jvanderberg/minipc-power/docs/skill-gaps.md

# kicad-skills gaps found while designing minipc-power

Running log of problems found in https://github.com/jvanderberg/kicad-skills (commit 3ba7b5f) while using it on this
board: things the skills miss, get wrong, or state without support. Each entry names the skill/file, what happened,
and a suggested fix.

Severity: **high** = would lead to a wrong or unsafe design if followed; **medium** = missing guidance that cost real
time or needed outside knowledge; **low** = friction, wording, tooling.

## General rules behind these gaps

The numbered entries below are incidents. Each one is an instance of one of these rules, and the rules are what the
skills should encode. Fixing only the exact incident would not prevent the next, different instance.

| # | Rule | Instances |
|---|---|---|
| R1 | **Requirements cover the whole operating envelope**: simultaneous loads, worst case, thermal, physical and connector area, what runs before what. | 1, 2, 3, 23, 25 |
| R2 | **Surface every assumption made in place of asking**, and never default it silently. The user decides. | 23, 26, 29 |
| R3 | **External data is a snapshot about one exact item**: stock, lifecycle, tool recommendations, datasheet values. Verify it is the exact orderable variant, and that the data is current, before building on it. | 10, 14, 29 |
| R4 | **Statements about third-party tools and sites go stale.** Date them, say how to re-verify them, and prefer steps that discover current behaviour. | 4, 11, 12, 32 |
| R5 | **Gather the authoritative references early, and re-consult them at the point of use.** Each phase starts from a brief that restates its own inputs and constraints, so it doesn't rely on what earlier parts of a long session remember. | 9, 13, 21, 22 |
| R6 | **Verify against the reference, not only against generic checks.** DRC/ERC prove electrical and manufacturing rules, not design intent. | 21, 24, 31, tool notes |
| R7 | **Every automated check has blind spots**: state what each one does not cover, and add a targeted check or a visual inspection for those. | 17, 31, 33, tool notes (silk under bodies, missing 3D models) |
| R8 | **Never suppress a whole category of validation output.** An exemption names the specific item and the reason, and is reported as exempted. | tool notes (DRC summary) |
| R9 | **A claim that a requirement can't be met is itself a claim needing evidence**: what was tried, what blocked it. Try the cheaper alternatives (smaller package, other value, other position) first. | 28 |
| R10 | **Decisions frozen in an earlier phase are checked for feasibility by the later phase before they are final.** If the later phase can't honour one, it goes back to the user as a decision, not a silent shortcut. | 26, 5 |
| R11 | **Shared resources need an allocation plan before sub-tasks consume them**: layers, board areas, routing channels, plane regions, reserved via sites. | 27 |
| R12 | **Every default or unused element is a recorded decision** (no-connect pins, straps, floating inputs), **and every external interface gets user-facing affordances** (labels, polarity, orientation). | 24, 33 |
| R13 | **One place owns each file format and each fiddly rule**: s-expression output, escaping, hole spacing. Generators describe intent, and shared tools enforce the rules. | 0, 16, 19, 20 |
| R14 | **Prefer standard, verified building blocks over imported or improvised ones**, and check imported ones against their source. | 17, 18, still-missing 8 |
| R15 | **Generated files are deterministic and match the tool's own canonical form.** An unchanged design regenerates byte-identical (stable ids from stable keys, stable order), a change touches only its own lines, and output matches what the tool itself writes (KiCad 10 stores net-class assignments as lists; we wrote strings, so every KiCad open rewrote them). Otherwise every rebuild is an unreviewable diff. | found moving minipc-power onto kicad_sexpr: random uuids + KiCad's uuid-sorted save gave a ~31,000-line diff for an unchanged board |

## Planning / interview (kicad-new-board)

1. **medium - No path for multi-amp 1S boards (power banks, handhelds).** `pcb-battery-power/SKILL.md` s4 makes a
   *linear* charger with power path the default for USB-powered 1S boards, and the scope note jumps from "1S hobby"
   straight to "tens of amps / e-bike packs - use a certified BMS". A 1S2P 18650 pack feeding a 5 V + 12 V boost at
   ~10-15 W (3-5 A from the cell) sits in between and is a very common hobby build (handheld emulators, portable
   displays, power banks). Nothing covers: switching NVDC chargers (BQ25895-class), power-bank SoCs (IP53xx, SW62xx),
   protector overcurrent thresholds vs a multi-amp boost load, or cell-current/derating for parallel cells.
   *Fix:* a "high-power 1S" section: switching charger with NVDC power path, protector + FET sized for boost peak
   current, parallel-cell matching, boost-from-cell current math (Iin = Pout / (eff x Vcell_min)).

2. **medium - The 15 W ceiling of 5 V USB-C is never applied to "charge while running".** `charging.md:102` says
   PD is needed above 15 W, but neither the interview guide nor the battery skill tells the planner to add the
   system load to the charge power and compare with what the input can deliver. Interview default "5 V, up to 1.5 A"
   (7.5 W) is below this board's load alone, so the default would have produced a board that discharges while
   plugged in. *Fix:* in interview step 4, require input power >= (system peak / eff) + (charge current x 4.2 V / eff)
   and recommend a PD sink when it fails.

3. **low - Interview has no "heat / enclosure thermal budget" question.** Size is asked, but "small sealed enclosure,
   must stay cool" was volunteered by the user and changes topology (switching vs linear charger, synchronous boosts,
   charge current limit). *Fix:* add "how hot may the board/box get, is there airflow?" to section 2 with a default.

## Battery / charging (pcb-battery-power)

5. **medium - PD sink coverage is one line, and misses the charger/PD interaction.** `charging.md:102` says "use a
   PD sink controller" and stops. Missing: (a) a charger's VINDPM (BQ25606: fixed 4.3 V / VBAT+200 mV) does nothing to
   protect a 9 V PD source, so the charger's input current limit must be at or below the negotiated PDO current
   (an 18 W charger gives 9 V / 2 A); (b) what the sink does when the requested voltage is not offered (CH224Q's
   datasheet does not say) and what input limit is safe then; (c) BC1.2-detecting chargers (BQ25606, BQ25895) only
   use the ILIM resistor when D+/D- detection returns "unknown" [BQ25606 s9.3.2.3], so whether D+/D- are wired to
   the connector changes the input limit. *Fix:* a "PD sink + charger" subsection covering these three.

6. **medium - Nothing on parallel cells (1SnP).** `chemistries.md` covers buying genuine 18650s but not paralleling
   them: same model/age, matched capacity, joined at the same voltage (or through a resistor) to avoid a large
   equalising current, one protector for the parallel group, per-cell current = pack current / n. *Fix:* a short
   section in `chemistries.md` or `protection-and-safety.md`.

7. **low - Protector trip current ignores gate drive.** `protection-and-safety.md:17` gives
   I_trip = V_OCD / (Rds,CHG + Rds,DSG), which is right, but the FETs in a DW01/HY2120 circuit are driven at roughly
   the cell voltage, so Rds(on) must be read at Vgs ~ 3 V (empty cell), not the 4.5 V headline figure - the trip
   current falls as the cell empties and the 8205A-class FETs trip around 3-5 A. *Fix:* add "read Rds(on) at
   Vgs = cell minimum" and a sizing example for a multi-amp load.

8. **low - Standalone vs I2C-default chargers not compared.** The battery skill names BQ2407x (linear), BQ25185 and
   BQ25895 (I2C) but not the standalone switching family (BQ25606/BQ25616: resistor-set ICHG/ILIM, no host). The
   power-supply skill's "startup independence" rule is the deciding argument and the battery skill should cross-link
   it: a charger that needs I2C cannot be configured by an MCU that it powers. *Fix:* add the standalone switching
   option to the charger-selection table in `charging.md`.

## Power design (pcb-power-supply)

9. **medium - WEBENCH is offered too late and too quietly.** The WEBENCH step is in `pcb-power-supply/SKILL.md` s3
   ("Choose the controller IC"), mid-paragraph. In practice the controller was chosen during kicad-new-board step 8
   (candidates) with pcb-part-selection, and the agent went straight to hand calculations from the datasheet; the user
   had to ask "do we have any tools for TI?" before WEBENCH was used. Neither kicad-new-board's component-selection
   step nor pcb-part-selection mentions it. *Fix:* in kicad-new-board step 8 and pcb-part-selection "Finding
   candidates", say: for any switching regulator, run WEBENCH (ask the user about the terms and a myTI login up front)
   *before* settling on a part and before hand sizing; make it a checklist item at the top of pcb-power-supply rather
   than a bullet inside s3. Also say plainly that WEBENCH does not cover battery chargers (BQ25xxx), so those stay
   datasheet-only.

10. **medium - WEBENCH results are not stock-filtered before use.** `webench.md` mentions "WEBENCH does not know what
    is in stock at JLC/LCSC" only in its last section, after the steps that pick and customize a design. On this
    board the 5 V run's top three (TPS61022, TPS61230A, TPS61236P) had 0 / 0 / 13 units in LCSC's global warehouse.
    Customizing any of them would have been wasted work. *Fix:* make the stock check step 2 of the WEBENCH flow: read
    the table view, pull every part number, run them through `jlcimport-cli search --region global` in one batch,
    and drop anything below the order quantity before opening Customize. A small script that takes the table text and
    prints stock per part would make this one command.

11. **low - WEBENCH can refuse a part the datasheet allows, without saying why.** Forcing TPS61178 at 3.0-4.35 V in,
    5 V / 2.5 A out returned "Design cannot be created! Your preferred device does not work with the inputs you
    selected" with no reason, although the datasheet allows 4.5-20 V out from 2.7 V in. `webench.md` does not say what
    to do then (vary Iout / Vin to find the limit, or fall back to the datasheet procedure). *Fix:* add a line on that.

12. **high (wrong statement) - "there is no KiCad/CAD export there" is false, and the PCB layout tab is not
    mentioned.** `webench.md` ("Export" paragraph) says the Export page has "no KiCad/CAD export". On 2026-10-24 the
    Export page offers **Altium Designer, Cadence OrCAD, TINA-TI, CadSoft EAGLE, Mentor Graphics and P-CAD** exports
    ("schematic, board, and simulation files"), and KiCad 10's `kicad-cli pcb import --format eagle|altium|pcad`
    reads three of those. Customize and Export also show a **PCB LAYOUT** tab with a per-layer reference layout
    (Top / Mid 1 / Mid 2 / Bottom). Following the skill, the agent skipped both and would have hand-placed every
    converter's hot loop instead of starting from TI's layout. *Fix:* replace the sentence; add a step: capture the
    PCB LAYOUT views for each chosen design and, with the user's permission to download, export EAGLE (or Altium),
    import with `kicad-cli pcb import`, and use the copper as the placement/routing reference for that converter
    (re-check against the datasheet layout guidelines; WEBENCH layouts use its own BOM footprints).

13. **medium - No "layout reference pack" step, and no stated order of authority between layout sources.**
    `pcb-power-supply` s6 says "copy the datasheet's layout example; then check against references/layout.md", and
    nothing else. Before placing any converter the skill should have the agent gather, per IC, into the project
    (e.g. `docs/layout-refs/<part>/`): (1) the datasheet's Layout Guidelines text and Layout Example figure (rendered
    with pdftoppm) - **primary, these win any conflict**; (2) the EVM user guide's layout if one exists; (3) the
    WEBENCH PCB LAYOUT views and imported EAGLE/Altium board - **reference only**, because they are drawn around
    WEBENCH's BOM (different inductor/capacitor sizes from the stocked LCSC substitutes) and a generic stackup.
    Then write down, per converter, the hot loop, the parts that must sit at the pins, the quiet-side parts, the
    feedback routing and the thermal-pad via count, and check the KiCad placement against that list. *Fix:* add
    this as a numbered step before s6 "Lay it out", and have kicad-pcb-workflow s1 ("Plan the change against real
    data") point to it for any switching converter.

## Schematic capture (kicad-pcb-workflow)

19. **medium (research miss) - No ready-made board setup / stackup; the agent had to hunt for syntax.** kicad-new-board
    says "set the physical stackup to the chosen JLC stackup" and `jlcpcb-stackups.md` gives the numbers, but nothing
    gives the KiCad syntax or a way to apply it: `kicad-cli` cannot create a project or board, and pcbnew's Python
    bindings do not expose `BOARD_STACKUP` (GetStackupDescriptor() returns an opaque SwigPyObject with no methods in
    KiCad 10.0.1). The agent ended up grepping the user's other projects for a board that happened to contain a
    `(stackup ...)` block to copy. *Fix:* ship template files with the skill - a blank 2-layer and 4-layer
    `.kicad_pcb` (+ `.kicad_pro` with JLC-safe design rules and net classes) per JLC stackup (JLC04161H-7628, -3313,
    ...), or a small script that writes the `(setup (stackup ...))` block and the `.kicad_pro` design settings from
    the table in `jlcpcb-stackups.md`.

16. **high - Nothing on creating a schematic or board from scratch, or on schematic readability.** kicad-pcb-workflow
    is entirely about *editing* existing files (checkpoint, patch, verify). It never covers: creating the project and
    first schematic, laying symbols out, and - since `kicad-cli` has no "update PCB from schematic" - getting a new
    schematic's footprints and nets onto a new board (has to be pcbnew python: load each footprint, set pad nets from
    the exported netlist). It also has no guidance on what a good generated schematic looks like; the default an agent
    reaches for is "every pin gets a net label", which the owner called unreadable. *Fix:* a "new design" section or
    a separate skill: (a) draw each functional block with real wires, power symbols for rails and ground, labels only
    between blocks; (b) left-to-right signal/power flow, inputs on the left, outputs on the right, ground at the
    bottom, supplies at the top; (c) minimise wire crossings, use junction dots only at real T-joins; (d) feel free to
    redraw an imported symbol with pins grouped by function (and fix "unspecified" pin types while doing it); (e)
    render the PDF and look at it before calling it done; (f) the netlist-to-board step with pcbnew.

17. **low - Imported footprints have no courtyard.** All 17 JLCImport footprints on this board lack F.CrtYd; the
    part-selection skill says to check for this, but kicad-pcb-workflow's DRC loop will not flag overlaps between
    parts without courtyards. *Fix:* add a script step that generates a courtyard (pad/body bounding box + 0.25 mm)
    for imported footprints that lack one.

18. **medium - Say up front that standard KiCad footprints are preferred over imported ones.** pcb-part-selection's
    "Importing into KiCad" treats the JLCImport footprint as the one to use (and then lists its usual defects). The
    owner's rule: **use KiCad's library footprint whenever the package is a standard one** (SOT-23, SOD-123F, 0402/0603,
    TI RGE/RHL/DQK, NexFET VSON-8, HRO USB-C, Littelfuse Nano2...), and keep the imported footprint only for genuinely
    part-specific packages (here: TPS61178 HotRod RNW, TPS63802 DLA, CH224Q DFN-10 with EP, FXL inductors). Notes for
    the skill: `jlcimport-cli import` has no switch for this (the GUI/TUI offer reuse; the CLI never passes the
    confirm callback), and its matcher `find_best_matching_footprint()` is wrong often enough that every suggestion
    needs checking - on this board it proposed a 12-pin 2x2.5 mm package for the 13-pin 3x3.5 mm TPS61178, a 3x2.5 mm
    package for the 3.5x4.5 mm TPS61088-Q1, a 3x3 mm EP part for the 2x3 mm TPS63802, Phoenix terminal blocks for both
    inductors and a 7.98x5.44 mm Bourns PTC for the Nano2 fuse. Also check pad numbering: KiCad's NexFET VSON-8
    merges source pins 5-8 into one pad "5", so the symbol needs matching pin numbers.

## Part selection (pcb-part-selection)

14. **high - No lifecycle (NRND/EOL) check, and distributor stock hides discontinued parts.** kicad-new-board step 8
    says "avoid NRND/EOL parts" but neither it nor pcb-part-selection says how to check. On this board WEBENCH
    recommended the TPS61088 (5 V boost) and LCSC listed 7,130 in stock, but ti.com/product/TPS61088 and its
    datasheet symlink both return 404 and TI's site search does not find it; only the automotive TPS61088-Q1 is
    still listed (ACTIVE). Stock at a distributor is not evidence that a part is still made. WEBENCH's own tell was
    "IC Cost: N/A" for that part (every active part showed a price). *Fix:* add to pcb-part-selection "Reading the
    datasheet": open the manufacturer's product page and record the lifecycle status (ACTIVE / NRND / LAST TIME BUY
    / OBSOLETE); a 404 product page or a missing datasheet link means treat as obsolete; and in webench.md, treat
    "IC Cost: N/A" as a lifecycle warning.

## Tooling

15. **low - render.py cannot render a board without an Edge.Cuts outline, even with --window.** It exits with "no
    Edge.Cuts outline found", which blocks rendering imported reference boards (the WEBENCH EAGLE imports have no
    outline). *Fix:* when --window is given, use it and skip the outline lookup.

4. **low - `jlcimport-cli` install not documented.** README lists it as a requirement with only a repo link. The
   repo's pyproject needs a modern pip (system Python 3.9 / pip 21 cannot do `pip install -e` on it) and a stale
   PyInstaller build in `dist/` lacks `--region`, which the skill's commands use. *Fix:* give the install command
   (`pipx install git+https://github.com/jvanderberg/kicad_jlcimport` or a venv with Python >= 3.11) and the minimum
   version that has `--region`.

## Routing (kicad-pcb-workflow)

20. **medium - no routing-as-data helper; the hand-written one missed same-net hole-to-hole spacing.** routing.md
    says to route with chosen coordinates kept as data, but ships nothing to do it, so each board writes its own
    track/via placer (`tools/routing.py` here). Its clearance check skipped same-net copper (right for copper
    clearance), so the GND pad-stitching pass put vias on top of hand-placed GND vias: 2 x `hole_to_hole` at 0.000 mm.
    DRC caught it. *Fix:* ship a tested router helper in kicad-pcb-workflow/scripts (pad lookup by REF/PIN, net taken
    from the pad, clearance + hole-to-hole + edge checks regardless of net, KiCad 10 s-expr output), or at least state
    the hole-to-hole rule in routing.md. Filed as https://github.com/jvanderberg/kicad-skills/issues/1.

21. **high - routing has no "follow the datasheet layout, then check against it" step.** kicad-pcb-workflow mentions
    the datasheet "layout example" only when choosing a part (SKILL.md:42). routing.md never mentions datasheet
    layout guidelines, the EVM or WEBENCH layouts, or a per-block compliance check. Here placement followed the
    figures. Routing drifted to pad coordinates and generic habits (global GND pour, a stitching via beside every GND
    pad), and those silently broke the BQ25606's own rules:
    - analog ground (ILIM/ICHG/TS resistors) must join power ground **only at the thermal pad**, but got plane vias
      and pour;
    - C_SYS belongs against SYS/GND pins 17/18 with a top-layer ground tie, but ended up 4 mm away, returning through
      the plane.
    DRC was clean throughout, so nothing flagged it. The user had to ask. *Fix:* in routing.md, make each converter /
    charger block a loop: (1) re-open that part's layout section and figure (plus the WEBENCH/EVM board as a secondary
    reference) before routing it; (2) route; (3) render the block net-coloured at the same scale as the figure and
    tick off each datasheet rule explicitly in a checklist file before moving on. Also call out the usual traps:
    single-point AGND vs blanket stitching/pour (a pour keepout is needed), cap ground returns on top copper vs via
    the plane, "no parallel layers on SW", and FB/COMP away from SW.

22. **high (process) - run each layout stage as its own agent session with a written brief (user suggestion).**
    Board design here is one very long session: requirements, part selection, WEBENCH, schematic, placement, routing.
    The datasheet layout figures and WEBENCH boards were collected early (docs/layout-refs/). By routing time they had
    dropped out of working attention, and were only re-read when the user asked (gap 21). A checklist file alone does
    not fix that if nothing forces it to be re-read. *Suggestion:* the skills should split layout into stages
    (placement; then routing per block: input/PD, charger, each converter, protection, planes/stitching; then review)
    and start each one in a fresh agent session. Each gets a brief built from the repo:
    - that block's datasheet layout rules and figure, plus the WEBENCH/EVM reference, from docs/layout-refs/<part>/;
    - its parts and nets (from netspec);
    - the board-wide rules (stackup, netclasses, keepouts);
    - the interfaces to neighbouring blocks (which pours and vias it must land on);
    - the done criteria: DRC clean, block nets connected, a net-coloured render compared with the datasheet figure,
      and every rule ticked in docs/layout-compliance.md.
    The brief is also the hand-off record, so a stage can be re-run without the whole conversation. Related: gap 21,
    and the s-expression/router tooling (gap 20), which makes stages independent because the board is regenerated
    from data rather than edited in place.

## Found in the end-of-session transcript review

Items from a pass over the whole session transcript (user corrections, tool failures, workarounds) that had not been
logged.

23. **medium - The interview never asks whether the board needs its own MCU / power controller.** The agent assumed
    "no MCU" without asking, and the user had to ask "when did we rule out an mcu?". The deciding argument (an
    external MCU cannot bootstrap its own power source, so anything that must be configured before the MCU runs
    needs a standalone part or an on-board controller) appears nowhere in kicad-new-board. *Fix:* add an interview
    question: "does anything need a controller before the main MCU runs (charger config, soft power switch, fuel
    gauge)?". Record the answer and the bootstrap argument in the requirements.

24. **medium - No guidance for pad-only (solder-point) boards: labels and polarity.** The user asked for every
    external connection as a solder pad. The skills say nothing about making such a board usable, and the user had
    to ask for "user readable labels and polarity" after the first 3D render. *Fix:* a short section in
    kicad-new-board / kicad-pcb-workflow:
    - every pad gets a function label on F.SilkS (and B.SilkS, mirrored);
    - consistent polarity: square = positive / signal, round = GND / negative;
    - pairs in a consistent order (+ then GND);
    - labels placed clear of footprint silk and courtyards (see the tool notes on silk under bodies and summary
      filtering).

25. **medium - The board-size estimate ignores connector / pad area.** The target was about 45 x 30 mm. 16
    through-hole solder pads plus two M2 holes (keep-out radius about 2.45 mm) pushed it to 52 x 36 mm, and the user
    had to offer more room. *Fix:* in kicad-new-board's size step, budget area for edge pads (pitch x count per
    edge), mounting-hole keep-outs and connector overhang before promising a size, and say the size is provisional
    until a placement pass.

26. **medium - Fine-pitch fan-out is not checked before the schematic is frozen.** CH224Q's D+/D- (0.4 mm pitch
    inner pins) could not be routed beside CC1/CC2 without crossings, so they were dropped at routing time. That
    quietly removed a feature (QC fallback on non-PD chargers). *Fix:* at placement (kicad-pcb-workflow s1), check
    escape routing for every pin of each fine-pitch part (<= 0.5 mm) against its connector before calling the
    schematic final. If a pin cannot escape, that is a schematic decision for the user, not a routing shortcut.

27. **medium - No board-level channel plan before per-block routing.** Routing block by block put the TS (thermistor)
    track on B.Cu under U6, exactly where the 3.3 V converter's PGND via had to go, and forced the EN bus to snake
    around the BAT strip. *Fix:* before routing any block, write a one-page layer / channel plan:
    - which nets own which inner-layer planes and B.Cu pours (e.g. the BAT strip);
    - reserved spots under each IC for ground / thermal vias;
    - the lanes for slow board-wide signals (EN, status, sense lines).

28. **medium - A layout rule marked "infeasible" needs recorded evidence.** The 12 V boost's VIN-pin bypass rule was
    written up as "no room", after checking only whether a 22 uF 0805 fitted. A 1 uF 0402 fitted (C37, added later).
    *Fix:* in the compliance checklist (gap 21), a deviation row must record what was tried: package sizes, positions,
    the blocking parts. The agent must try the smallest sensible package and a different value before declaring a
    datasheet rule unachievable.

29. **low - Switching to a part variant means re-deriving every value from that variant's datasheet.** WEBENCH
    designed around the commercial TPS61088, which turned out discontinued. The available TPS61088-Q1 has a
    different ILIM equation (R = 550000 / I, 0.6 V reference vs 1.204 V) and higher Rds(on). Neither webench.md nor
    pcb-power-supply warns that a variant (-Q1, A/B suffix, package option) can differ in equations and limits.
    *Fix:* a note: re-run WEBENCH on the exact orderable variant, or re-derive every resistor from that variant's own
    datasheet.

30. **low - Viewing vs editing, and reporting paths.** Two related frictions:
    - The kicad_open.sh lock makes the agent refuse to regenerate while the user only wants to look ("open it in
      kicad for me", "I won't edit it").
    - The user had to ask for full paths in summaries.

    *Fix:* for viewing, open a copy in the scratchpad (or say the board is read-only and will be regenerated on
    close). In kicad-new-board's reporting guidance, give absolute paths for every artifact.

31. **low - render.py full-board renders are unreadable once a GND pour exists.** Everything is one colour.
    kicad-board-review's view.py (net-coloured, with a grid) was the tool that worked for checking routing.
    *Fix:* kicad-pcb-workflow's rendering reference should point to view.py for routing checks, or render.py should
    gain a net-colour mode.

32. **low - Datasheet and reference-pack handling.** Several problems:
    - TI datasheet "symlink" URLs return an HTML page (not a PDF) for discontinued parts.
    - pdftotext prints font errors on some TI PDFs.
    - The layout pack saved neighbouring pages without saying which PNG holds the figure, and the support page was
      opened twice in place of the layout example.

    *Fix:* the download step checks the `%PDF` magic. The pack README names the figure page per part (e.g.
    `tps61178-12v/datasheet-p30.png = fig. 36`). A small "find the page that contains section X / figure N" helper
    would replace the repeated grep-per-page loops.

33. **low - No-connect pins hide decisions.** ERC no-connect flags make every unused pin pass silently. TPS61088-Q1's
    MODE pin was left floating (correct: internal 800 k pull-up selects PFM), but that was only checked at routing
    time. *Fix:* a no-connect audit that lists each NC pin with the datasheet pin-table text, so each choice is made
    deliberately.

## Found running kicad-board-review (2026-10-24, GitHub main 77055cd)

34. **medium - The starter review config silently classifies most switch nodes as "slow".** `make_pack.sh` writes
    `review_config.example.json`, whose switch regex (`-SW\d?\)$|_LX$|^SW_NODE`) only matches nets KiCad names after an
    IC's SW pin. Here two of three converter switch nodes were named after a capacitor pad (`Net-(C4-Pad2)`,
    `Net-(C24-Pad2)`) and the buck-boost's are `U6-L1/L2`; the first pack reported "loops 0 fast 0" with no warning.
    *Fix:* classify switch nodes from the netlist (a net joining an IC pin named SW/LX/L1/L2/PH to an inductor), and
    have `emc.py` warn when an inductor-connected net or a configured hot-loop IC ends up unclassified.

35. **medium - `nc_audit.py` treats a no_connect-typed pin as decided.** U5 (TPS61088-Q1) pins 11/12 were "symbol NC"
    with an empty note and passed `--require-notes`, but the pin table says "connect these two pins to ground plane".
    *Fix:* a pin named NC still needs a datasheet note; print the pin-table text for it like any other unused pin.

36. **medium - Design currents ignore the source's own series resistance.** The checklist and the battery skill size a
    battery path as P / (eff x Vcell_min). With ~70-100 mOhm of FETs, fuse, BATFET, copper and wires, 15 W at a 3.0 V
    cell is 6.8 A, not 5.6 A, past this charger's 6.0 A BATFET trip (latches off until USB). *Fix:* solve
    I x (Vcell - I x R_path) = P / eff and compare with every element's limit (BATFET OCP, protector, fuse derating,
    converter UVLO at the resulting VSYS); `power.py` could report the copper part of R_path per run.

37. **medium - "Small capacitor at the pins" items from the datasheet's typical application are easy to drop.** WEBENCH's
    BOM for the TPS61088 omitted the 1 uF output capacitor that the datasheet's typical application (C9) and layout
    figure show at the VOUT pins; the compliance check ticked "C_OUT at the VOUT pins" against the 47 uF parts 3 mm away.
    *Fix:* in pcb-power-supply's reference-pack step, list every capacitor in the datasheet's typical application with
    its position in the layout figure, and diff that list against the BOM (WEBENCH is a secondary source).

38. **low - Load-switch and inrush timing is not in any checklist.** A P-FET load switch driven straight from EN
    (Q5, 10 nF gate cap) connected the load before the boost started; inrush then comes through the boost's rectifier
    body diode with no limit. *Fix:* checklist item: every output switch has a defined turn-on time, compared with the
    upstream converter's soft-start and the upstream current trips.

39. **low - `board_diff.py` bugs.** (a) `board_diff.py HEAD <board>` fails when the board is not at the repo root: it runs
    `git show HEAD:<basename>` with cwd = the board's folder, which git resolves from the repo root (use `HEAD:./<name>`).
    Worked around with `HEAD:hardware/minipc-power.kicad_pcb`. (b) It does not report changed footprint fields: R7, R16
    and C32 value / LCSC changes were invisible ("0 unexpected change groups").

40. **low - `check.sh` cannot see a project's pin-decision notes.** It runs `nc_audit.py` without `--notes`, so it
    reports "19 without a decision" for a project whose own build finds 0 (notes in `docs/pin-decisions.json`). *Fix:*
    `--notes FILE` passthrough, or look for `pin-decisions.json` next to the project / in `docs/`.

41. **low - `planes.py` reports a pour of another net as one board-sized slot.** The B.Cu BAT pour plus the tracks that
    touch its clearance came out as a "44.4 x 31.9 mm slot" (the bounding box of the merged hole). *Fix:* report other-
    net pours separately from slots, and give each slot its own extent.

42. **low - `emc.py` reference check on a 4-layer board with a power plane.** Every B.Cu track is "not over ground"
    because the nearest plane is In2 (VSYS), even where it runs inside a B.Cu GND pour. That's correct as geometry but
    drowns the list; say "over VSYS plane (decoupled?)" as a separate, lower-priority category.

43. **low - The hot-loop metric measures pad-to-pad geometry only.** U6's loop looked fine (2-2.5 mm) while its
    return went through one 0.2 mm via; the solver showed it. *Fix:* for each configured hot loop, run a small DC solve
    from the cap's GND pad to the IC ground pin and report the via share and the top-layer share.

44. **low - Environment.** `jlcimport-cli` was not installed (the README's `pipx install git+...` worked: v1.6.7);
    KiCad's python prints a wx "traits" assert on every `boarddump.py` run; `view.py` puts the title and some labels
    outside the axes for small windows. `docs/layout-refs/tps63802-3v3/` holds p28 and p29 with nothing
    saying fig. 12-1 is on p28 (p29 is the documentation-support page; gap 32 again).

45. **medium - The project builds deterministically only against an unpublished kicad-skills.** With GitHub main's
    `kicad_sexpr`, `gen_schematic.py` writes random uuids (an unchanged design gave a ~18k-line diff). The deterministic
    writer is on an uncommitted local branch. Publish it, and pin the kicad-skills revision a project builds with
    (e.g. a `KICAD_SKILLS_REV` in `tools/kskills.py` checked at build time).

## Found during the datasheet, heat and protection rework (2026-10-25, kicad-skills main 8dcd3da)

46. **high - Datasheet links were dropped by every stage.** All 87 BOM parts had empty Datasheet fields in the schematic
    and on the board although JLCImport writes an LCSC link into every symbol it imports: the redrawn symbols started
    from `datasheet=''`, passives kept KiCad's "~", schgen ignored the library value and board_setup never copied the
    netlist's `<datasheet>` element. Fixed here (symbols.DATASHEETS, LCSC link per part, board_setup copies it, generators
    refuse a blank) and in kicad-skills (R22, `partfields.py`).

47. **high - Heat was never budgeted.** The review skill had no thermal model ("temperature rise needs judgment") and a
    one-line checklist item with no required output, so it was skipped. The battery path (protection FETs, BATFET, fuse)
    turned out to be 3-4 times the converter losses at the 15 W corner. See thermal.md; kicad-skills branch `thermal`
    adds the heat table and solver (R23).

48. **high - Stock was checked in the wrong region.** `jlcimport-cli search` without `--region` uses the CLI's default
    (here `cn`): the first FET chosen for the heat fix (SiSS80DN, C3289423) showed 12,000 in stock, the user approved it,
    and the block was re-laid out around it before `bom_check.py` (`--region global`) reported 0 for JLCPCB assembly.
    Availability belongs to (part, assembler, region, quantity, date) and has to be checked at selection time.

49. **medium - A part swap changed a derived value and an approved decision.** The HY2113 senses over-current across
    Q2 + Q3, so the trip current depends on the FET's RDS(on): the protector variant had to be re-chosen for each FET,
    and the substitution was started without asking. Derived values need a "depends on" note so a swap re-derives them,
    and a change to an approved part or threshold goes back to the owner.

50. **low - `power.py` crashes on a renamed net.** After the part swap KiCad renamed `Net-(J3-Pad1)` to `Net-(Q1-D)`;
    the run failed with a numpy NaN error instead of "run batn_q1: net not on the board".

51. **low - `bom_check.py`'s summary swaps two counts** ("0 extended, 38 without a datasheet link" meant the reverse).

52. **low - via_near put vias inside a neighbouring same-net pad** (Q3's source pads): via_ok's obstacle set skips
    same-net copper, so an unfilled via landed in the next pad. Fixed in tools/routing.py (no via on any pad but the
    one it stitches).

## Tool notes

Changes or workarounds to existing tools (skills' scripts, jlcimport). None of the skills' scripts have been modified
so far; workarounds are listed here.

- `render.py` (kicad-pcb-workflow): refuses boards without Edge.Cuts even with `--window` -> worked around by adding
  a temporary `gr_rect` outline to a copy of each imported WEBENCH board (`docs/layout-refs/*-view.kicad_pcb`).
- `jlcimport-cli import`: no way to choose a KiCad library footprint -> footprints are assigned in the schematic
  generator instead; the importer's matcher was called directly from Python to get its suggestions.
- KiCad 10.0.1's library footprints reference 3D models that are not installed (Fuse_Littelfuse-NANO2-451_453,
  USB_C_Receptacle_HRO_TYPE-C-31-M-12): the 3D render silently shows bare pads. Worked around by pointing those
  footprints at the JLCImport models (`placement.MODEL_OVERRIDE`, offsets corrected for the KiCad footprint origin).
  The skill's 3D-render step should check every footprint's model path exists and flag missing ones.
- pcbnew python: `FOOTPRINT.Models()` returns copies, so setting `m_Filename` / `m_Offset` on them does nothing
  (no error). Model paths are rewritten as text in `tools/board_setup.py`. Belongs in `pcbnew-api.md`'s failure table.
- `tools/routing.py` (this repo): `via_ok` now rejects any via within `(size_a + size_b)/2 + 0.1 mm` of an existing
  via of any net (gap 20).
- `tools/routing.py` (this repo): added `keepout()` (pour-free rule areas, KiCad 10 syntax copied from a library
  footprint's keepout zone) for the analog-ground islands of the charger, 12 V and 3.3 V converters (gaps 21-22).
- KiCad DRC passed with pad labels (F.SilkS) under component bodies. It only checks silk against pads, so the 3D
  render was the only thing that caught it. A "silk text vs courtyard" check belongs in check.sh or the board review.
- `tools/build_board.sh` (this repo): its DRC summary dropped every `silk*` type to hide one known warning (J1's
  outline at the board edge). That hid three real silk overlaps (pad labels printed over J16 / J7 outlines), which KiCad
  had reported. Now only that exact J1 case is exempted. Lesson for the skills' check.sh / drc_summary: exempt
  specific known items by name, never a whole category.
- `jlcimport-cli import C6331050`: "No component found" (no EasyEDA data) -> substituted FXL0530-R47-M (C475515).

## Tools that would have prevented the issues found so far

Built for this project (in `tools/`, candidates to move into the skills):

1. **`netspec.py` - intended netlist vs KiCad export.** The circuit written once as data ({net: [REF.PIN...]}),
   compared with `kicad-cli sch export netlist`: reports SPLIT (one intended net became several) and SHORT (a KiCad
   net mixes intended nets), tolerant of two-pin passive orientation. ERC did not catch VSYS shorted to GND in the
   first generated draft (it only complained about an open-collector pin on a power output); this did, immediately.
2. **`schgen.find_merges()` - locate the short.** Union-find over the drawn geometry (wire ends, pin points, power
   symbols, labels) that prints the exact wire or pin coordinates where two intended nets merge. Turned "VSYS is on
   GND somewhere" into "C14 pin 2 at (105.41, 242.57) sits on the FB wire".
3. **`schgen.Sch` - wire-drawn schematic writer** with pin-coordinate transforms (rotation/mirror), automatic
   junctions, wire splitting at T-taps, and no reliance on net labels inside a block.
4. **`symbols.ic()` / `symbols.fet()` - symbol redraw.** Pins grouped by function with real pin types and stacked
   duplicates; FET symbols renumbered to the KiCad footprint's pads (e.g. NexFET pad 5 = merged source).
5. **`symlib.py` / `fpinfo.py` - dump symbol pins and footprint pads** side by side to check numbering before
   assigning a footprint.

Still missing (would have helped):

0. **(highest value) An s-expression object model + serializer for KiCad files, in the skills layer.** This
   project's generator builds `.kicad_sch` text with hand-written format strings
   (`'\t\t(property %s %s\n\t\t\t(at %s %s %s)...' % (...)`). That caused two of this session's bugs (a stray
   `'''` fragment inside a format string, and a duplicated property name) and makes every new feature (mirrored
   symbols, extra visible fields, field angles) a string-surgery exercise. What the skill should provide: typed
   objects (Sheet, SymbolInstance, LibSymbol, Pin, Wire, Junction, Label, PowerSymbol, Text; Board, Footprint, Pad,
   Track, Via, Zone) with one serializer that writes KiCad 10 syntax, uuids, instances and lib_symbols embedding, plus
   a reader for round-trips - so a generator only describes the logical design ("place U2 here, wire VBUS to C2.1")
   and never formats text. The same layer can enforce the gotchas file-format.md lists (no raw newlines, escaped
   quotes, `{slash}` in board net names, insertion anchors). Existing open-source Python libraries to evaluate
   first rather than writing from scratch: kiutils, kicad-skip (not checked here for KiCad 10 format support).

6. **Collision check before writing**: any part's pin landing on another net's wire, two wires sharing a column/row
   segment, a part body overlapping a wire or another body, and text overlapping text - all checkable from the
   geometry the generator already has. Most of this board's drawing faults were "a shunt cap's ground pin lands on a
   signal wire that runs 7.62 mm below the rail it hangs from".
7. **Block layout helpers** that reserve space: "ladder" placement (rail on top, shunts below with their ground
   symbols, signals routed below the lowest ground symbol) so the generator cannot put a signal row inside a shunt's
   span.
8. **Footprint vs datasheet land-pattern check**: pad count, pitch, EP size and pin-1 position from the datasheet's
   recommended land pattern against the chosen footprint; and a matcher wrapper that refuses a KiCad footprint whose
   body size or pin count differs from the LCSC package string (jlcimport's matcher proposed wrong sizes/pin counts
   for four parts).
9. **Lifecycle + stock gate**: one command that takes every MPN/LCSC number and reports manufacturer lifecycle
   (product page status, 404 = suspect) and LCSC global stock vs order quantity - would have caught TPS61088
   (discontinued, distributor stock still listed) and the HY2120 2-cell mix-up if it also echoed the datasheet title.
10. **WEBENCH table -> stock filter**: paste/scrape the table view's part numbers and get stock per part before
    customizing anything.
