jvanderberg/minipc-power/docs/webench/12v-tps61178.md

# WEBENCH: 12 V rail, TPS61178RNWR (design 33, 2026-10-24, logged in)

Inputs: Vin 3.0-4.35 V, Vout 12 V, Iout 0.5 A, ambient 50 C, max height 5 mm, ceramic caps, shielded inductors,
Balanced. Customized: user frequency 1.0 MHz, current limit 4.5 A (WEBENCH default was 9.37 A), PFET isolation on.

| Ref | Value | WEBENCH MPN | Notes |
|---|---|---|---|
| L1 | 2.7 uH, 18 mOhm DCR | Murata 1255AY-2R7N=P3 (IDC 4.6 A) | need I_sat > ILIM max (~6.2 A) - substitute |
| Cin | 2 x 22 uF 16 V 1210 (36 uF derated) | Taiyo MSASE32MSB7226MPNB25 | |
| Cout | 3 x 22 uF 25 V 1210 (31 uF derated) | Murata GRM32ER61E226KE15L | |
| Cout1 | 4.7 uF 25 V 1206 (3.2 uF derated) | TDK C3216X7R1E475K160AC | before the disconnect FET |
| Cvcc | 4.7 uF 25 V 0805 | | |
| Cboot | 100 nF 0805 | | |
| Rt | 169 k | | 986.6 kHz |
| Rilim | 162 k | | 745/162 = 4.6 A typ |
| Rfbt / Rfbb | 732 k / 80.6 k | | 12.08 V |
| Rcomp / Ccomp | 44.2 k / 1.8 nF | | no Cp |
| Rgate / Cgate | 178 k / 22 nF | | disconnect FET gate |
| M3 | P-FET -20 V | TI CSD25404Q3 | |

Operating values at Vin 3.0 V, Iout 0.5 A: efficiency 94.8 %, phase margin 54.9 deg, crossover 13.0 kHz, gain margin
reported "-11.91 dB" (gain at the phase crossover), duty 75 %, L ripple 0.82 App, IC peak switch current 2.31 A,
average input 2.11 A, Cout RMS 0.91 A, Cin RMS 0.12 A, IC Pd 251 mW, L Pd 80 mW, total Pd 331 mW, IC Tj 57.1 C at
50 C ambient (theta-JA 28.5 C/W assumed), Vout ripple 15 mVpp, Vout tolerance 2.84 %.
