jvanderberg/minipc-power/docs/webench/3v3-tps63802.md

# WEBENCH: 3.3 V rail, TPS63802DLAR (design 36, 2026-10-24, logged in)

Inputs: Vin 3.0-4.35 V, Vout 3.3 V, Iout 1.5 A, ambient 50 C, max height 5 mm, ceramic caps, shielded inductors.

Candidates vs LCSC global stock: TPS63802DLAR 37,457 (chosen); TPS63805YFFR 5,445 (WCSP/BGA - avoid);
TPS63806 78; TPS63810 260 (I2C); TPS63811 0; TPS63020DSJR 23,487 (older, 25-50 uA Iq, 3x4 VSON; fallback).

| Ref | Value | WEBENCH MPN |
|---|---|---|
| L1 | 470 nH, 7.6 mOhm | Coilcraft XFL4015-471MEB (IDC 9.1 A) - substitute |
| Cin | 22 uF 6.3 V 0603 (8.7 uF derated) | Murata GRM188R60J226MEA0D |
| Cout | 22 uF 10 V 0805 (11 uF derated) | Taiyo MSASL219LB5226MTNA01 |
| Rfbt / Rfbb | 511 k / 91 k | 3.31 V |
| Rpg | 100 k | PG pull-up |

At 3.0 V / 1.5 A: eff 91.1 %, 1.36 MHz, CCM, L ripple 0.64 App (36.5 %), IC peak 2.06 A, Iin 1.81 A, IC Pd 457 mW,
L Pd 24 mW, total 483 mW, IC Tj 65.6 C (theta-JA 34 C/W), Vout ripple 19.8 mVpp, tolerance 2.73 %.
(No loop data: internally compensated.)
