jvanderberg/minipc-power/docs/layout-refs/webench-raw/d33/ExportFiles/Schematic/webench_schematic_exchange_design_18395157_33_Eagle/Eagle/2026-10-24_14-10-09/readme.txt

 

**********************************************************
*************  Important Instructions Follow  ************
**********************************************************
 
All files exported to: C:\\CADExport\\workspace\Eagle\2026-10-24_14-10-09\2026-10-24_14-10-09

To import your new library into Eagle:
1. Start Eagle.
2. In the control panel window, Select File -> New -> Library from the menu.
3. In the blank library window, select File -> Execute Script from the menu.
5. Browse to your newly exported Eagle Script file (".scr" file extension)
6. After opening the file, the script will populate the new library.
7. Use File -> Save (or Save As..) to save the library to the desired location in Eagle native format.

**************************************************************
**    !!!!!!!!!!!!!        WARNING        !!!!!!!!!!!!!     **
**************************************************************

Besure to check the documentation layer, "48"/"Document", for important information that may seem to be missing or have not translated properly!

For additional information, please visit this site:
http://www.accelerated-designs.com/help/Eagle_import.html

You may also find this video helpful:
http://youtu.be/5jGuWY-Yy3Q

Ultra Librarian Gold 8.3.103 Process Report

Message - Padstack "RX44Y57D0T" Shape(4) is a CIRCLE with no diameter.
Message - Padstack "RX44Y106D0T" Shape(4) is a CIRCLE with no diameter.
Message - Padstack "R10632240000200A" Shape(4) is a CIRCLE with no diameter.
Message - Padstack "RX14Y13D0T" Shape(4) is a CIRCLE with no diameter.
Message - Padstack "RX22Y24D0T" Shape(4) is a CIRCLE with no diameter.
Message - Padstack "R10280100000200A" Shape(4) is a CIRCLE with no diameter.
Message - Padstack "R10141380000206A" Shape(4) is a CIRCLE with no diameter.
Message - Padstack "RX44Y71D0T" Shape(4) is a CIRCLE with no diameter.
Message - Padstack "R10200250000209A" Shape(4) is a CIRCLE with no diameter.
Message - Symbol "CSD25404Q3DQG" has as multiple attributes named "Value".
One of the attributes was renamed to "VALUE_2".
Message - Symbol "WB_CAPACITOR" has as multiple attributes named "TYPE".
One of the attributes was renamed to "TYPE_2".

TextStyle count:  24
Padstack count:   9
Pattern count:    8
Symbol count:     8
Component count:  19

Export

Component "WB_BATTERY" has no mapped footprint will be skipped.
Component "WB_GND" has no mapped footprint will be skipped.
Component "WB_CURRENT_LOAD" has no mapped footprint will be skipped.
