jvanderberg/minipc-power/docs/layout-refs/webench-raw/d36/ExportFiles/Schematic/webench_schematic_exchange_design_18395157_36_Eagle/Eagle/2026-10-24_14-12-33/readme.txt

 

**********************************************************
*************  Important Instructions Follow  ************
**********************************************************
 
All files exported to: C:\\CADExport\\workspace\Eagle\2026-10-24_14-12-33\2026-10-24_14-12-33

To import your new library into Eagle:
1. Start Eagle.
2. In the control panel window, Select File -> New -> Library from the menu.
3. In the blank library window, select File -> Execute Script from the menu.
5. Browse to your newly exported Eagle Script file (".scr" file extension)
6. After opening the file, the script will populate the new library.
7. Use File -> Save (or Save As..) to save the library to the desired location in Eagle native format.

**************************************************************
**    !!!!!!!!!!!!!        WARNING        !!!!!!!!!!!!!     **
**************************************************************

Besure to check the documentation layer, "48"/"Document", for important information that may seem to be missing or have not translated properly!

For additional information, please visit this site:
http://www.accelerated-designs.com/help/Eagle_import.html

You may also find this video helpful:
http://youtu.be/5jGuWY-Yy3Q

Ultra Librarian Gold 8.3.103 Process Report

Message - Padstack "RX26Y38D0T" Shape(4) is a CIRCLE with no diameter.
Message - Padstack "RX22Y24D0T" Shape(4) is a CIRCLE with no diameter.
Message - Padstack "R10280140000202A" Shape(4) is a CIRCLE with no diameter.
Message - Padstack "R10390140000202A" Shape(4) is a CIRCLE with no diameter.
Message - Padstack "R10550140000227A" Shape(4) is a CIRCLE with no diameter.
Message - Padstack "RX44Y128D0T" Shape(4) is a CIRCLE with no diameter.
Message - Padstack "RX44Y128D0TSM2" Shape(4) is a CIRCLE with no diameter.
Message - Padstack "RX44Y57D0T" Shape(4) is a CIRCLE with no diameter.

TextStyle count:  24
Padstack count:   8
Pattern count:    5
Symbol count:     7
Component count:  10

Export

Component "WB_GND" has no mapped footprint will be skipped.
Component "XFL4015-471MEB" has the following missing dependency and will be skipped: Footprint "XFL4015-M"
Component "WB_CURRENT_LOAD" has no mapped footprint will be skipped.
Component "WB_BATTERY" has no mapped footprint will be skipped.
