jvanderberg/minipc-power/docs/layout-refs/bq25606-charger/datasheet-p34-34.png

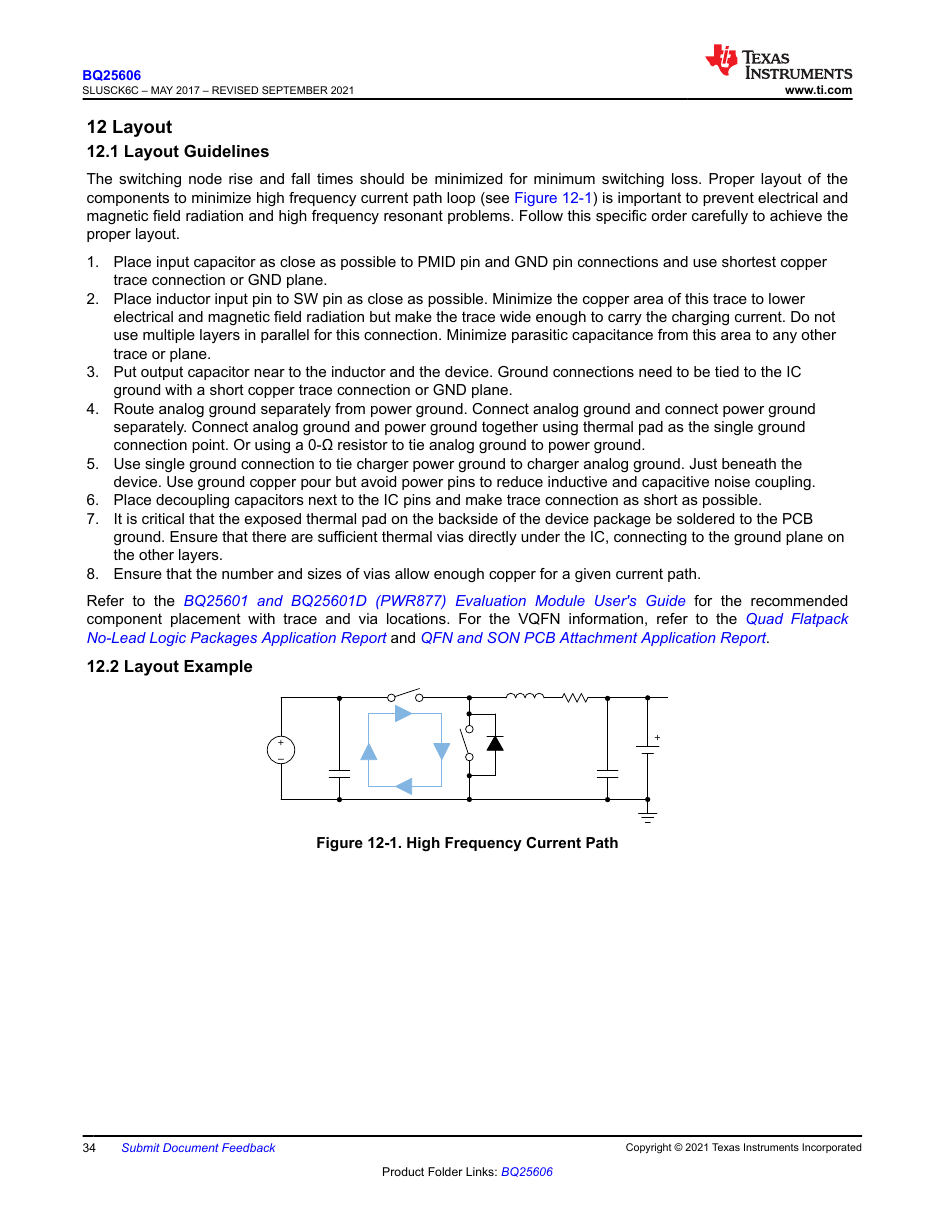
docs/layout-refs/bq25606-charger/datasheet-p34-34.png
