jvanderberg/minipc-power/docs/layout-refs/bq25606-charger/datasheet-p35-35.png

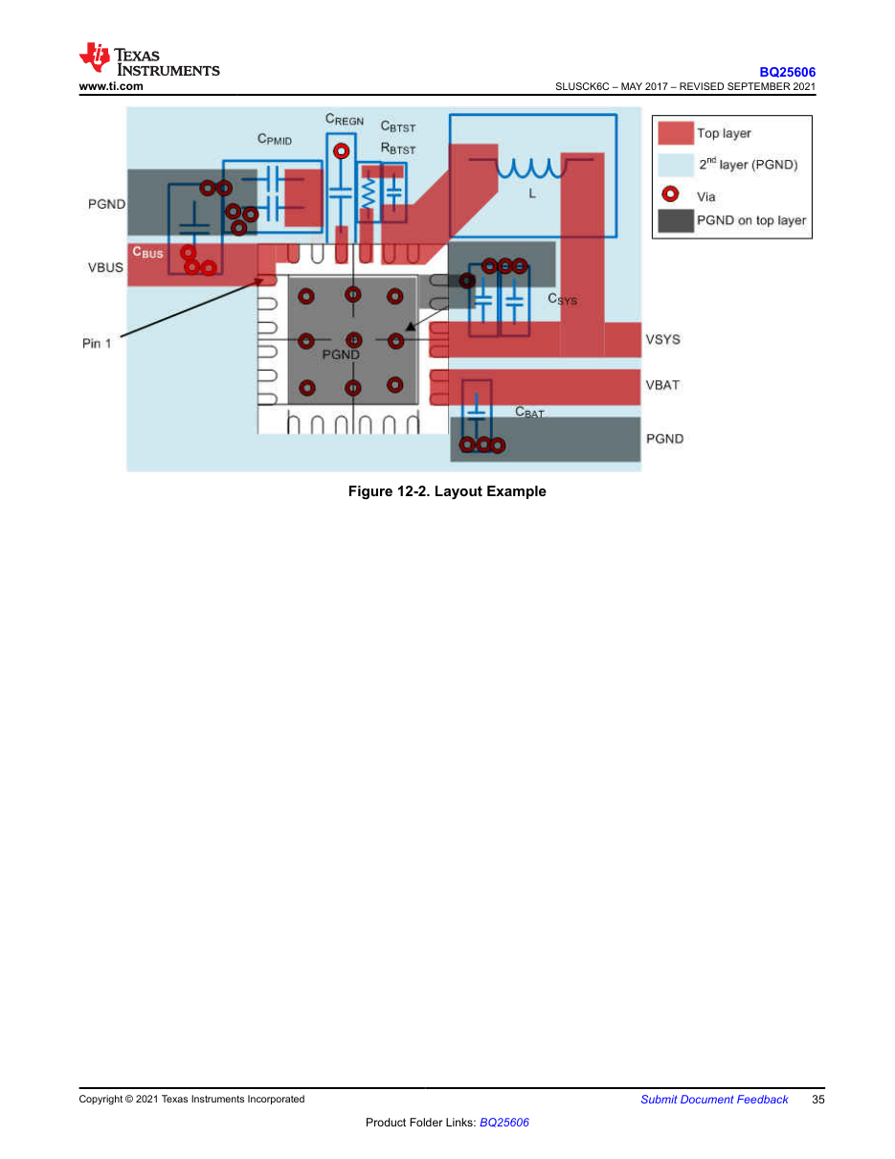
docs/layout-refs/bq25606-charger/datasheet-p35-35.png
