jvanderberg/minipc-power/docs/layout-refs/tps61088-5v-commercial-REJECTED/webench-d35-In2.Cu.png

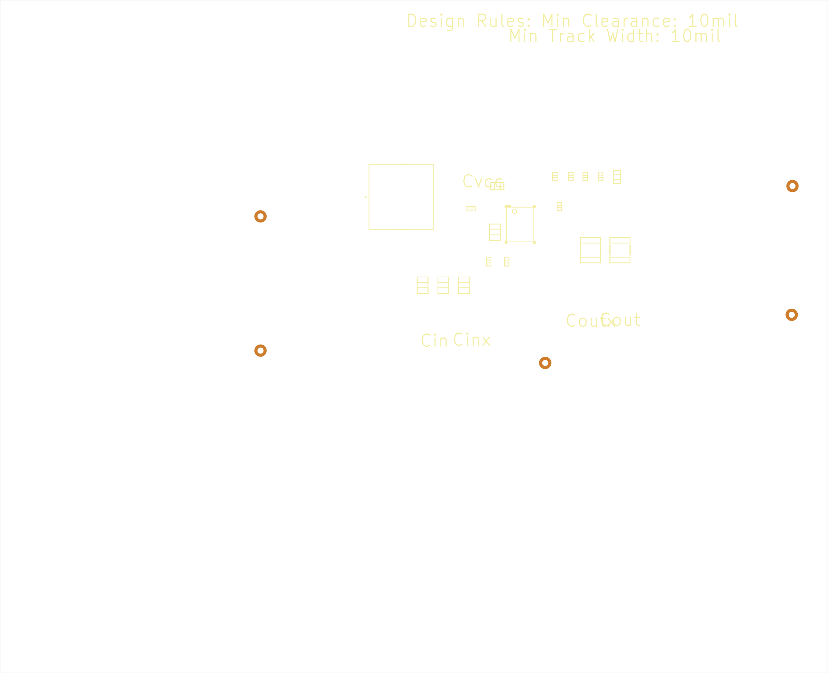
docs/layout-refs/tps61088-5v-commercial-REJECTED/webench-d35-In2.Cu.png
