jvanderberg/minipc-power/docs/layout-refs/tps61088-5v/webench-d35-F.Cu.png

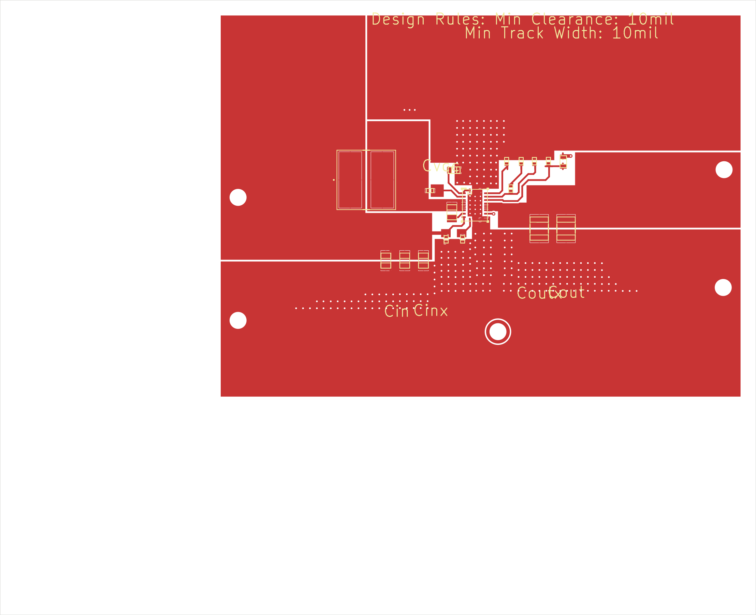
docs/layout-refs/tps61088-5v/webench-d35-F.Cu.png
