jvanderberg/minipc-power/docs/layout-refs/tps61088q1-5v/datasheet-p23-23.png

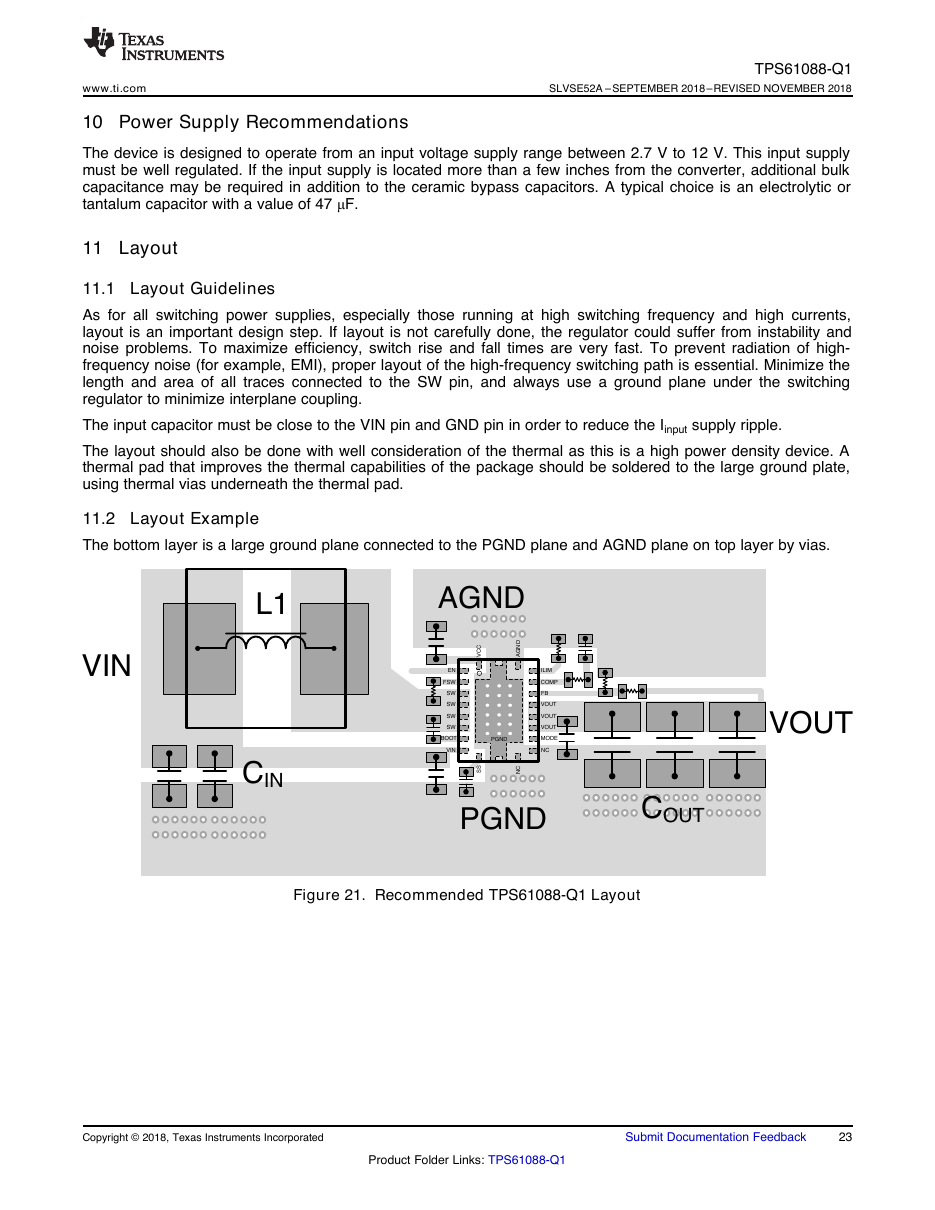
docs/layout-refs/tps61088q1-5v/datasheet-p23-23.png
