jvanderberg/minipc-power/docs/layout-refs/tps61088q1-5v/datasheet-p24-24.png

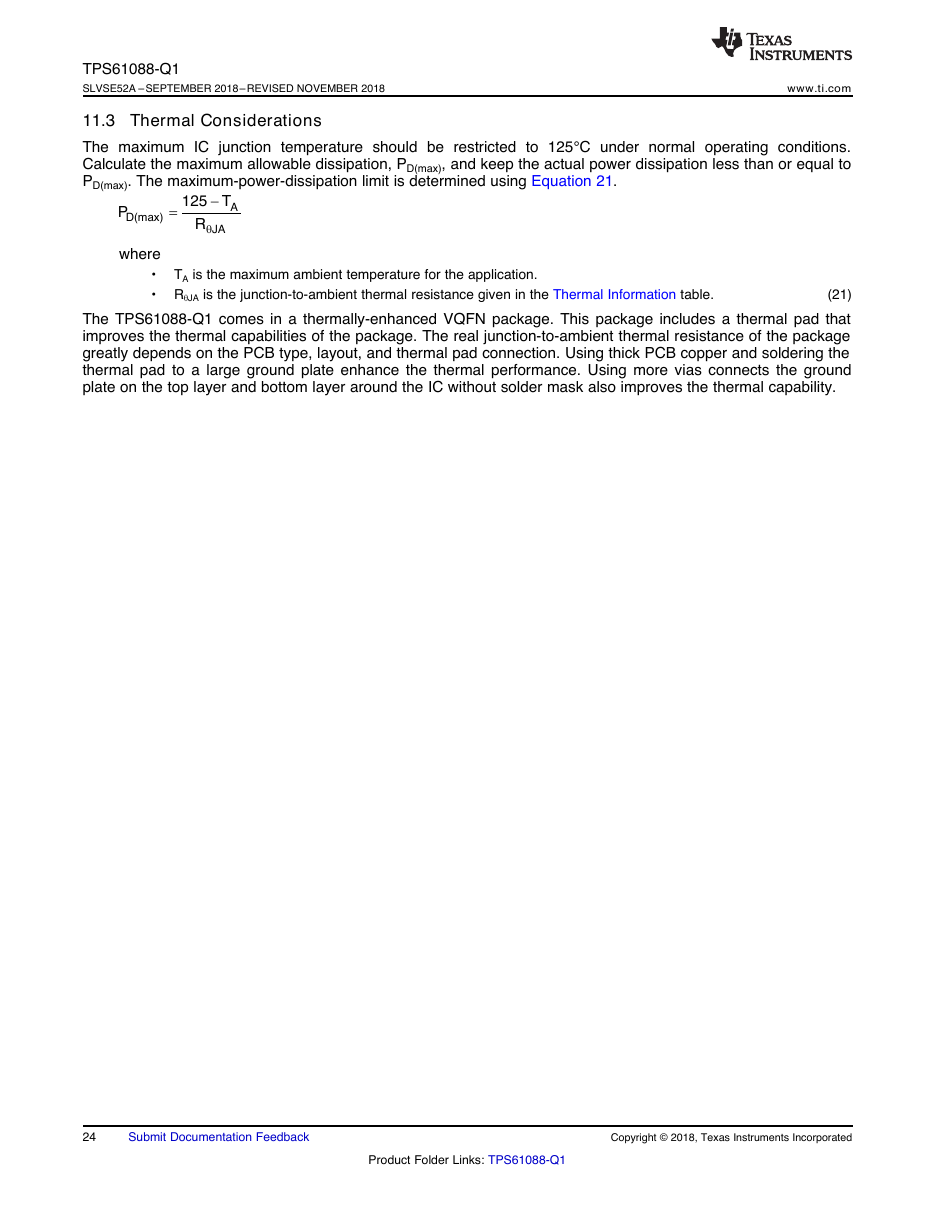
docs/layout-refs/tps61088q1-5v/datasheet-p24-24.png
