jvanderberg/minipc-power/docs/layout-refs/tps61178-12v/datasheet-land-pattern.png

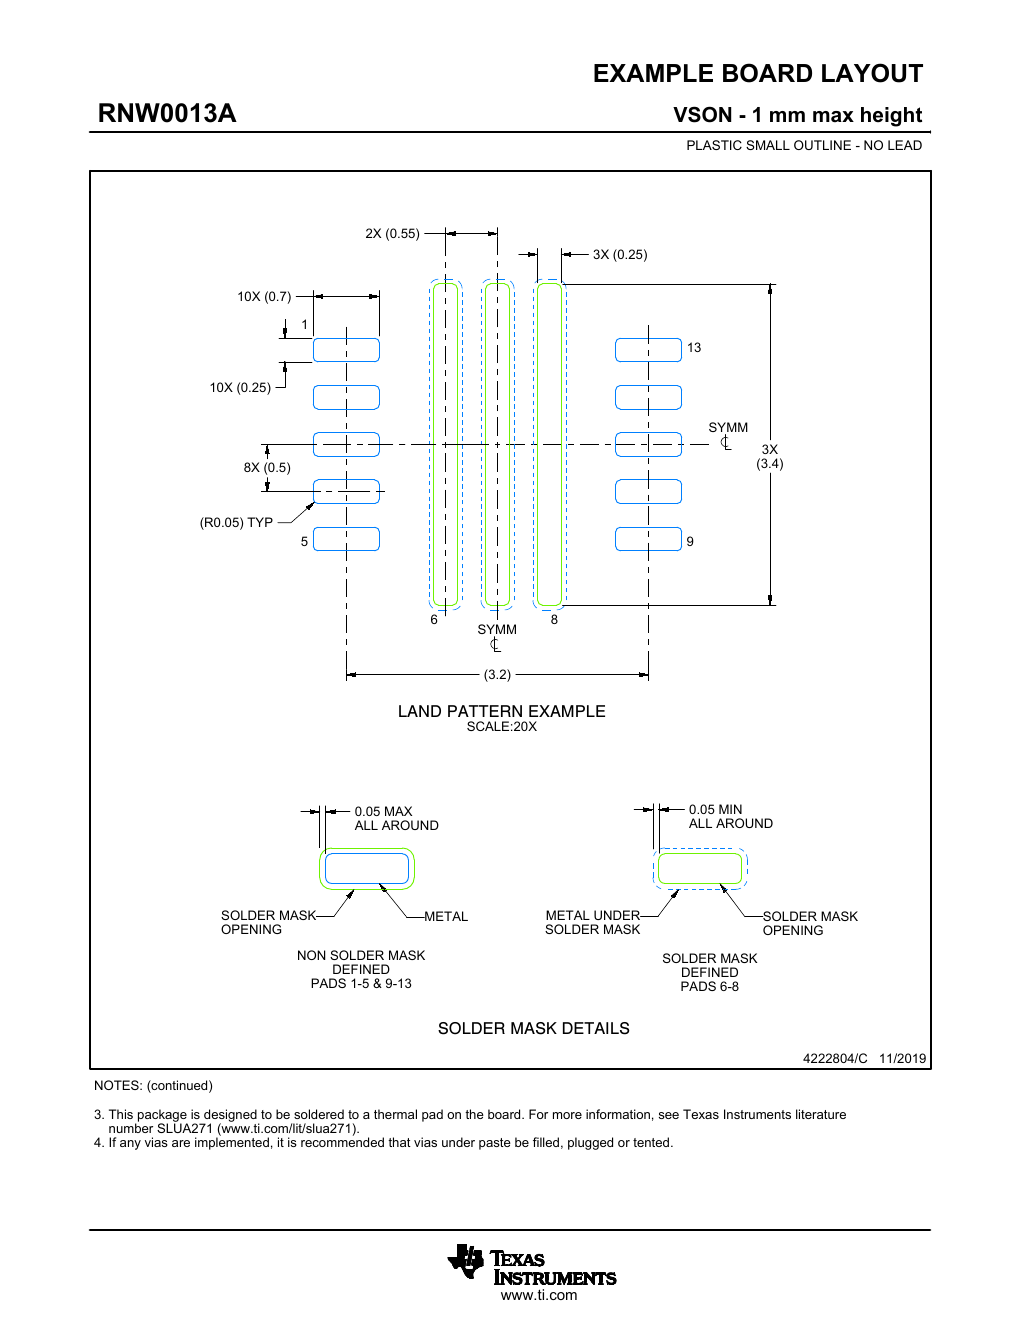
docs/layout-refs/tps61178-12v/datasheet-land-pattern.png
