jvanderberg/minipc-power/docs/layout-refs/tps61178-12v/datasheet-p30-30.png

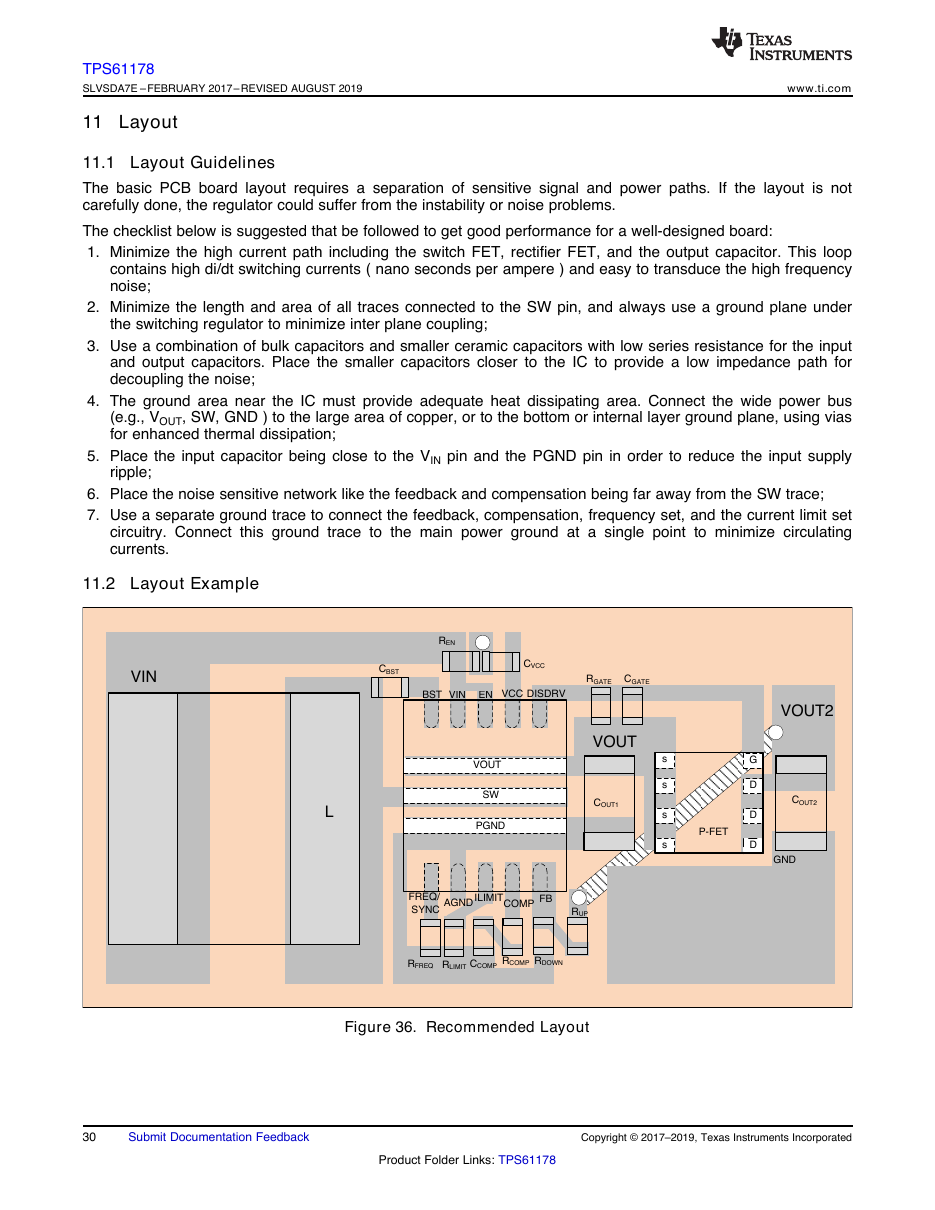
docs/layout-refs/tps61178-12v/datasheet-p30-30.png
