jvanderberg/minipc-power/docs/layout-refs/tps61178-12v/datasheet-p31-31.png

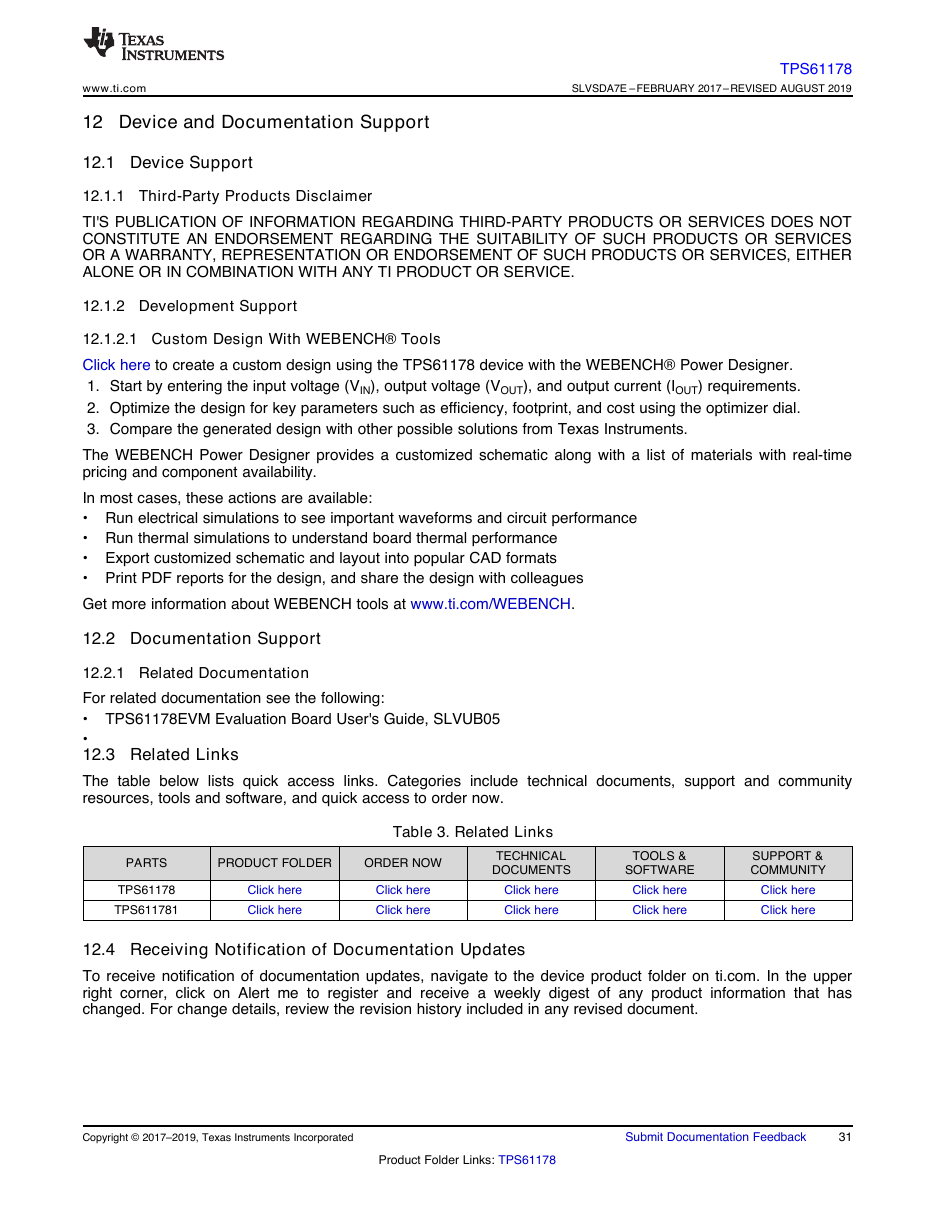
docs/layout-refs/tps61178-12v/datasheet-p31-31.png
