jvanderberg/minipc-power/docs/layout-refs/tps61178-12v/webench-d33-F.Cu.png

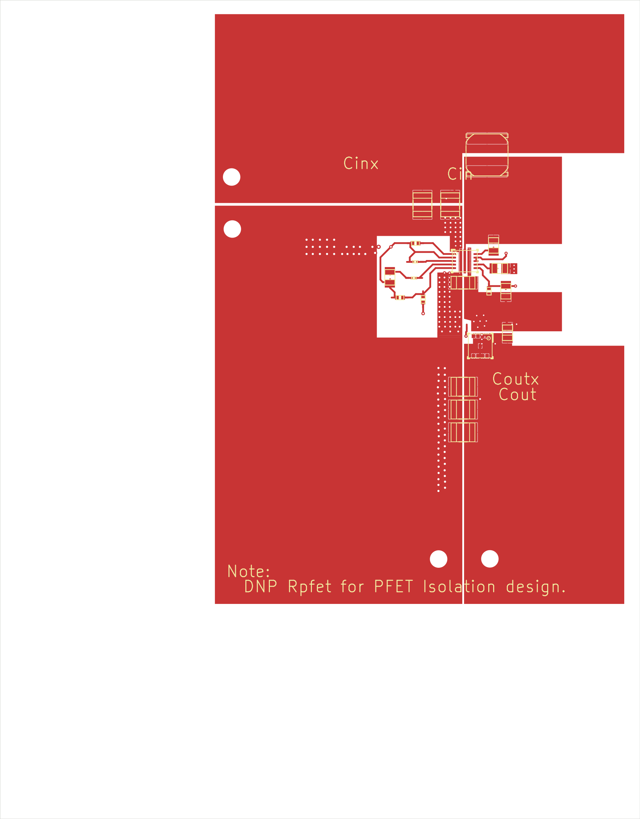
docs/layout-refs/tps61178-12v/webench-d33-F.Cu.png
