jvanderberg/minipc-power/docs/layout-refs/tps61178-12v/webench-d33-In1.Cu.png

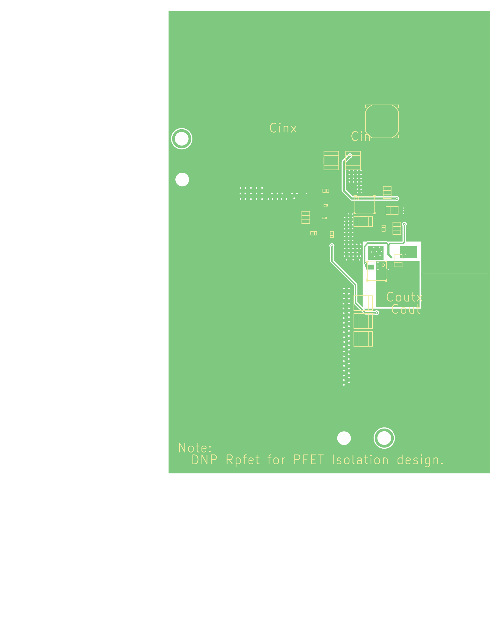
docs/layout-refs/tps61178-12v/webench-d33-In1.Cu.png
