jvanderberg/minipc-power/docs/layout-refs/tps63802-3v3/datasheet-land-pattern.png

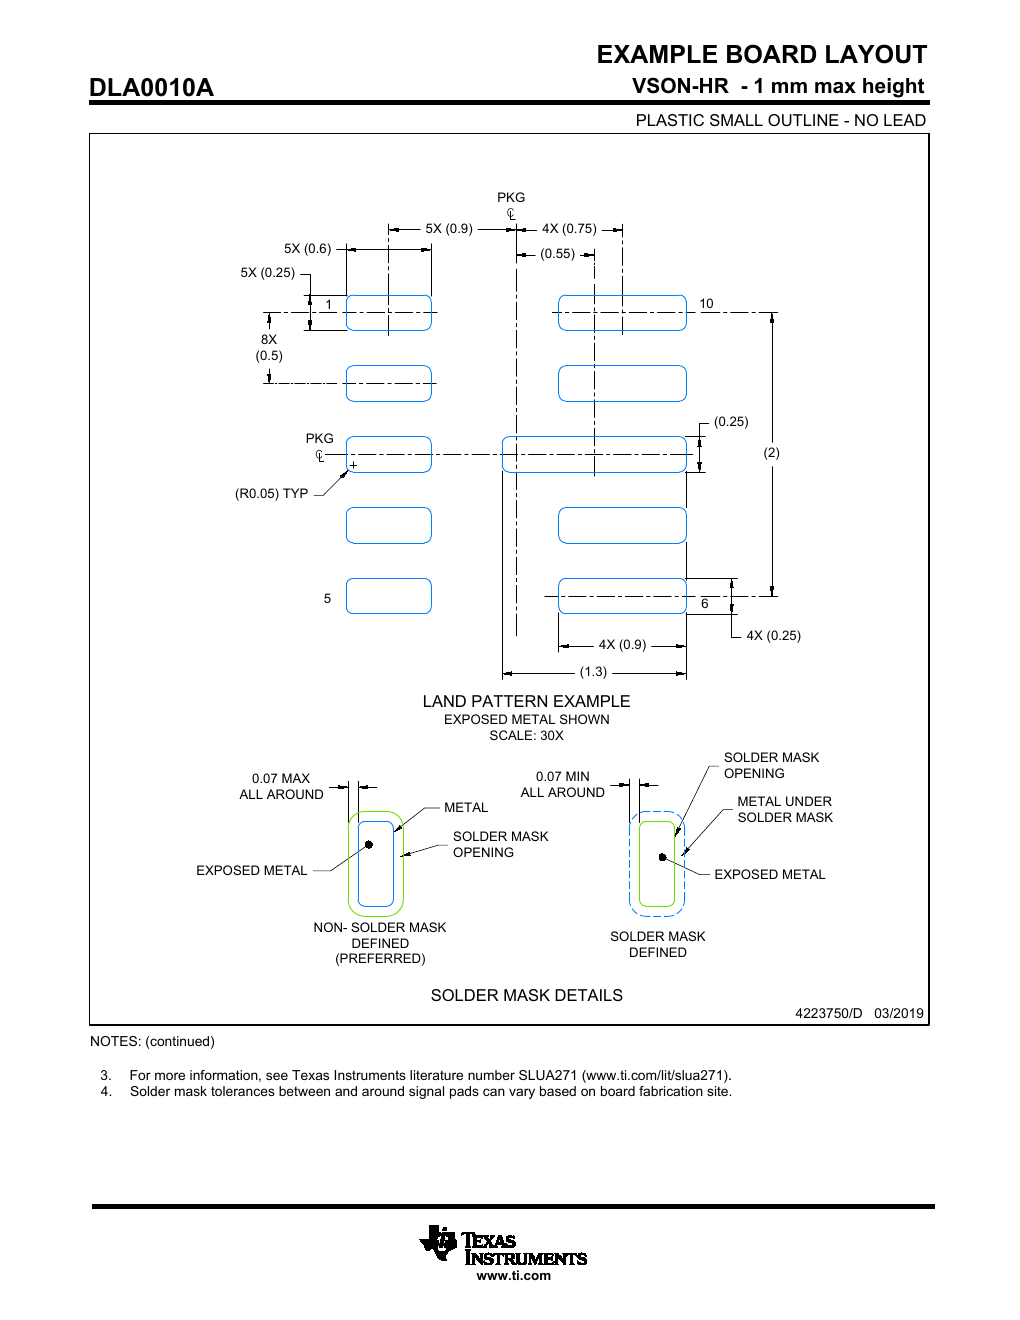
docs/layout-refs/tps63802-3v3/datasheet-land-pattern.png
