jvanderberg/minipc-power/docs/layout-refs/tps63802-3v3/datasheet-p28-28.png

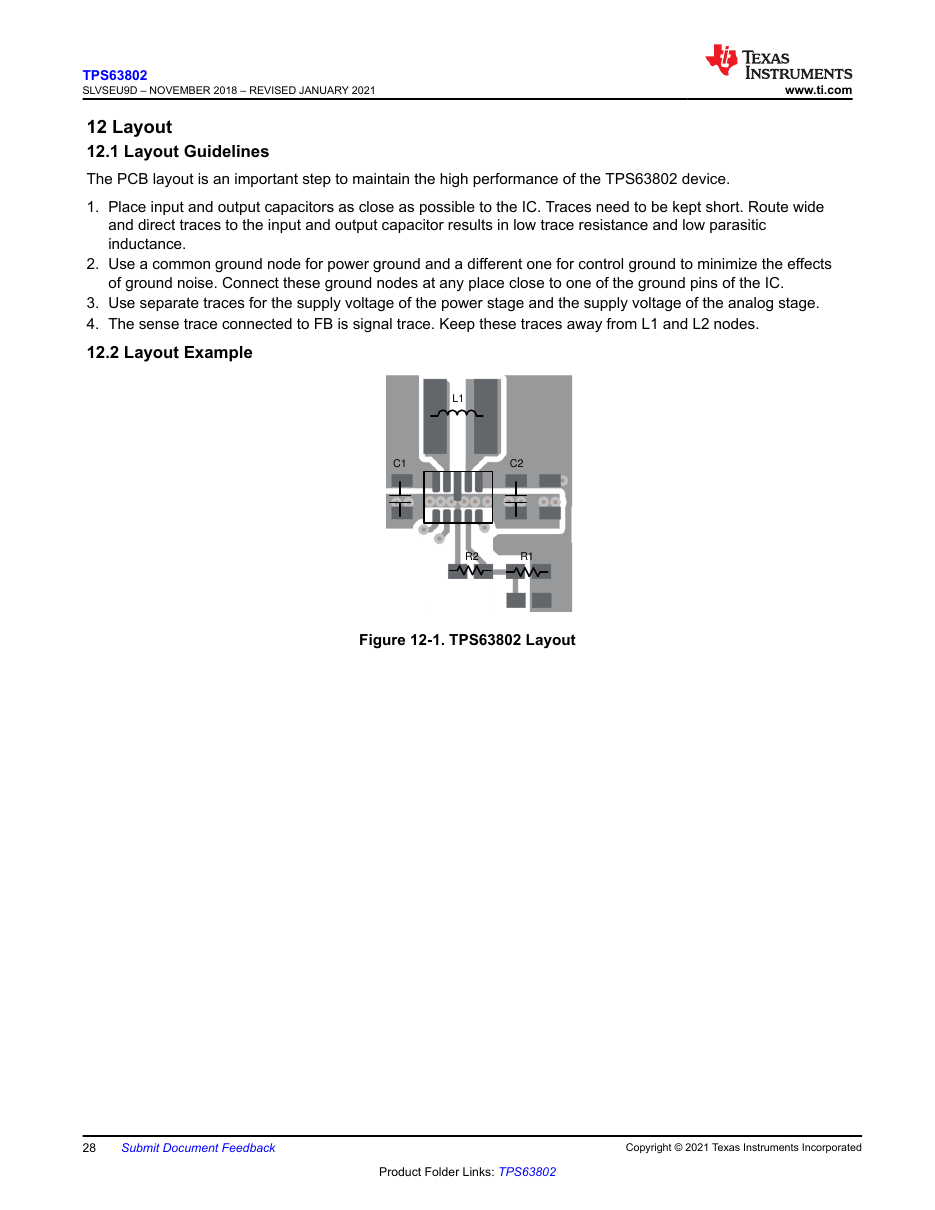
docs/layout-refs/tps63802-3v3/datasheet-p28-28.png
