jvanderberg/minipc-power/docs/layout-refs/tps63802-3v3/datasheet-p29-29.png

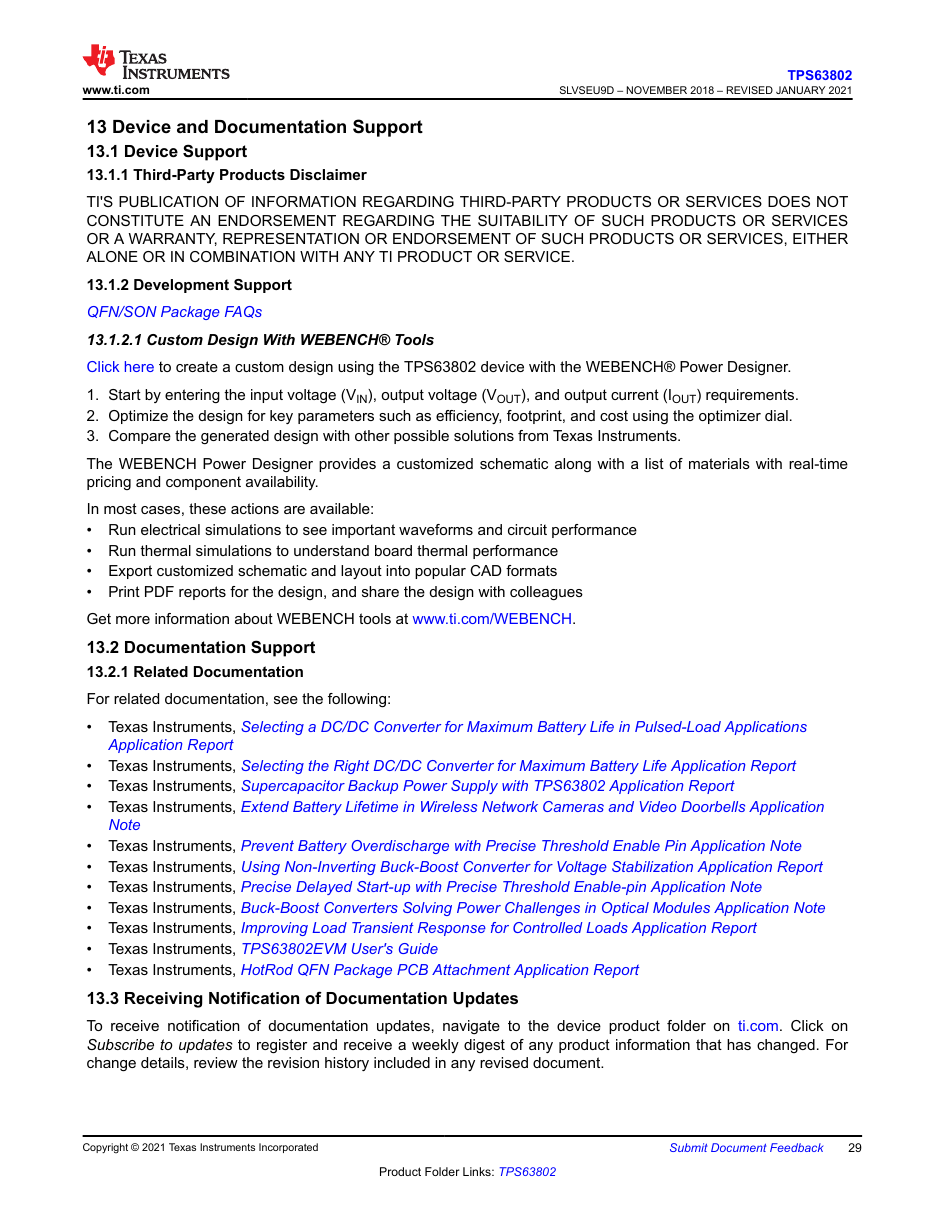
docs/layout-refs/tps63802-3v3/datasheet-p29-29.png
