jvanderberg/minipc-power/docs/layout-refs/tps63802-3v3/webench-d36-F.Cu.png

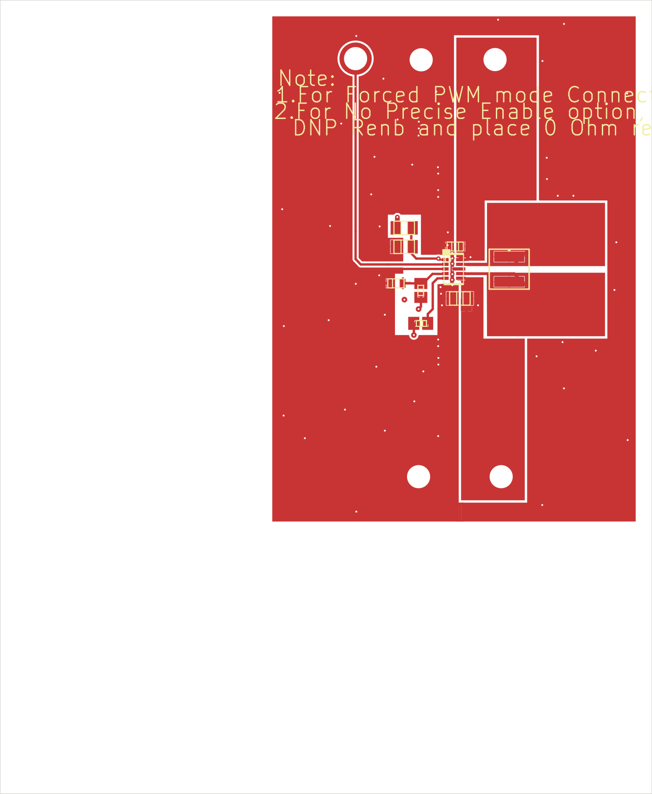
docs/layout-refs/tps63802-3v3/webench-d36-F.Cu.png
