jvanderberg/minipc-power/docs/layout-refs/tps63802-3v3/webench-d36-In2.Cu.png

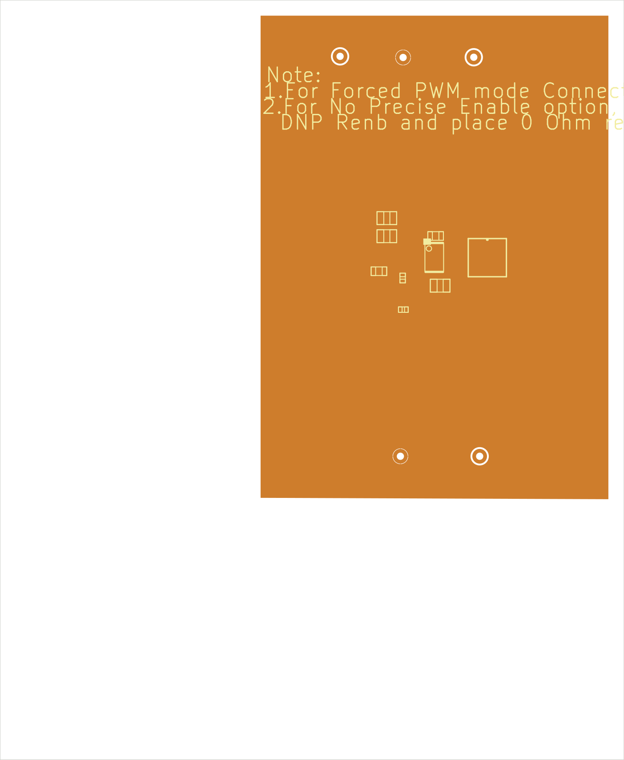
docs/layout-refs/tps63802-3v3/webench-d36-In2.Cu.png
