jvanderberg/minipc-power/docs/renders/placement-3d-bottom.png

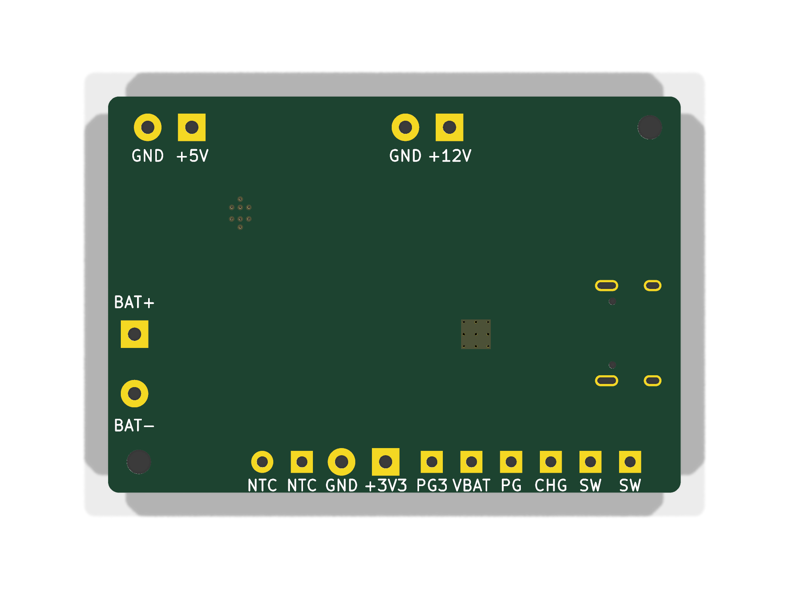
docs/renders/placement-3d-bottom.png
