jvanderberg/minipc-power/docs/renders/placement-3d.png

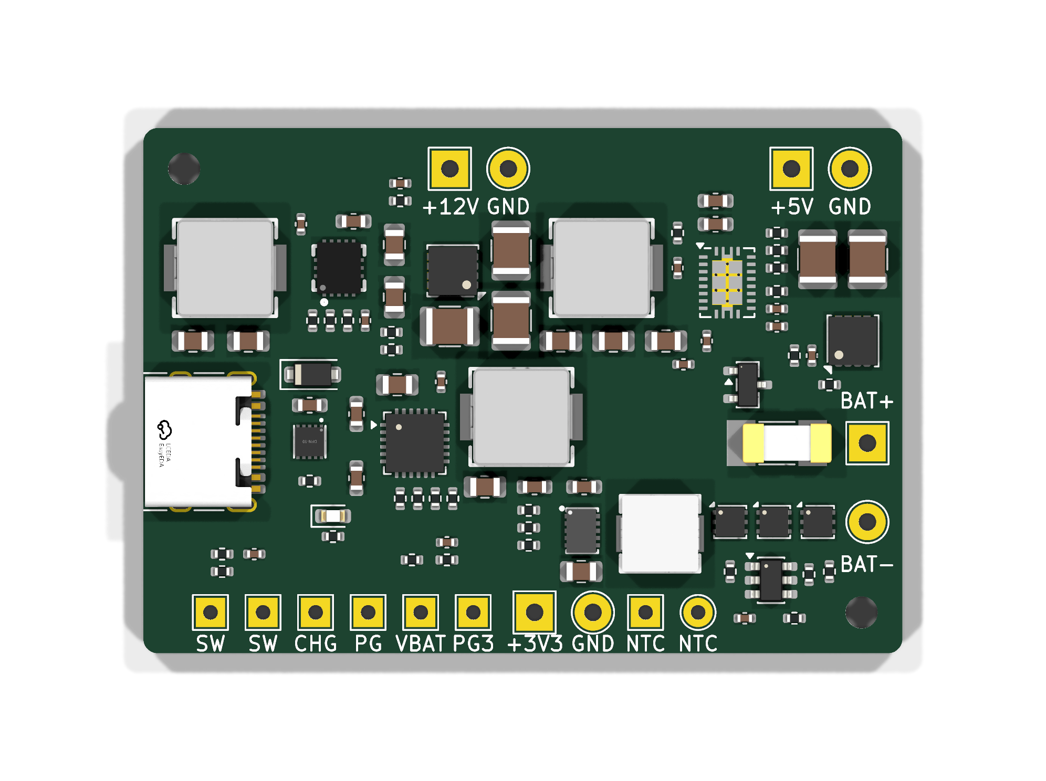
docs/renders/placement-3d.png
