jvanderberg/minipc-power/hardware/production/bom.csv

Designator | Footprint | Quantity | Value | LCSC Part #
C1, C2, C25, C26 | 0603 | 4 | 1uF | C15849
C10, C34, C9 | 0805 | 3 | 22uF | C45783
C11, C23, C24, C32, C35, C36, C8 | 0402 | 7 | 100nF | C1525
C12, C7 | 0603 | 2 | 4.7uF | C19666
C13 | 0402 | 1 | 1.8nF | C107024
C14, C15 | 0805 | 2 | 4.7uF | C1779
C16 | 0402 | 1 | 22nF | C337699
C17, C18, C19 | 1210 | 3 | 22uF | C52306
C20, C21, C22, C3, C5 | 0805 | 5 | 10uF | C15850
C27 | 0402 | 1 | 10nF | C15195
C28 | 0402 | 1 | 680pF | C307451
C29 | 0402 | 1 | 33pF | C70465
C30, C31 | 1210 | 2 | 47uF | C77101
C33 | 0603 | 1 | 22uF | C59461
C37, C38 | 0402 | 2 | 1uF | C52923
C4 | 0402 | 1 | 47nF | C307434
C6 | 0603 | 1 | 10uF | C19702
D1 | D_SOD-123F | 1 | SMF12A | C123800
F1 | Fuse_Littelfuse-NANO2-451_453 | 1 | 10A | C44479
J1 | USB_C_Receptacle_HRO_TYPE-C-31-M-12 | 1 | USB-C HRO TYPE-C-31-M-12 | C165948
L1 | FXL0630-2R2-M | 1 | 2.2uH | C167218
L2 | FXL0630-3R3-M | 1 | 3.3uH | C167219
L3 | FXL0630-1R0-M | 1 | 1uH | C167216
L4 | FXL0530-R47-M | 1 | 0.47uH | C475515
LED1 | 0603 | 1 | red | C2286
Q1, Q2, Q3 | Texas_DQK | 3 | CSD13202Q2 | C187839
Q4, Q5 | VSON-8_3.3x3.3mm_P0.65mm_NexFET | 2 | CSD25404Q3 | C2865523
Q6 | SOT-23 | 1 | 2N7002 | C8545
R1 | 0402 | 1 | 6.8k | C25917
R10, R30 | 0402 | 2 | 1M | C26083
R11 | 0402 | 1 | 169k | C25758
R12 | 0402 | 1 | 162k | C54068
R13 | 0402 | 1 | 732k | C27016
R14 | 0402 | 1 | 80.6k | C25921
R15 | 0402 | 1 | 44.2k | C25895
R16, R22, R26, R28 | 0402 | 4 | 100k | C25741
R17 | 0402 | 1 | 267k | C270622
R18, R20 | 0402 | 2 | 69.8k | C26985
R19 | 0402 | 1 | 220k | C25767
R2 | 0402 | 1 | 249 | C25096
R21 | 0402 | 1 | 28.7k | C26972
R23, R9 | 0402 | 2 | 10k | C25744
R24 | 0402 | 1 | 511k | C64042
R25 | 0402 | 1 | 91k | C144733
R27, R6 | 0402 | 2 | 1k | C11702
R29 | 0402 | 1 | 470k | C25790
R3 | 0402 | 1 | 470 | C25117
R4 | 0402 | 1 | 5.23k | C25907
R5 | 0402 | 1 | 30.9k | C270615
R7 | 0402 | 1 | 100 | C25076
R8 | 0402 | 1 | 2k | C4109
U1 | CH224Q_C46061833 | 1 | CH224Q | C46061833
U2 | Texas_RGE0024H_VQFN-24-1EP_4x4mm_P0.5mm_EP2.7x2.7mm_ThermalVias | 1 | BQ25606 | C374063
U3 | SOT-23-6 | 1 | HY2113-MB1A | C168772
U4 | TPS61178RNWR | 1 | TPS61178 | C127918
U5 | Texas_VQFN-RHL-20_ThermalVias | 1 | TPS61088-Q1 | C1850341
U6 | TPS63802DLAR | 1 | TPS63802 | C2845237
