jvanderberg/minipc-power/hardware/minipc-power.kicad_pcb

## KiCad design hardware/minipc-power.kicad_pcb (2026-10-25)

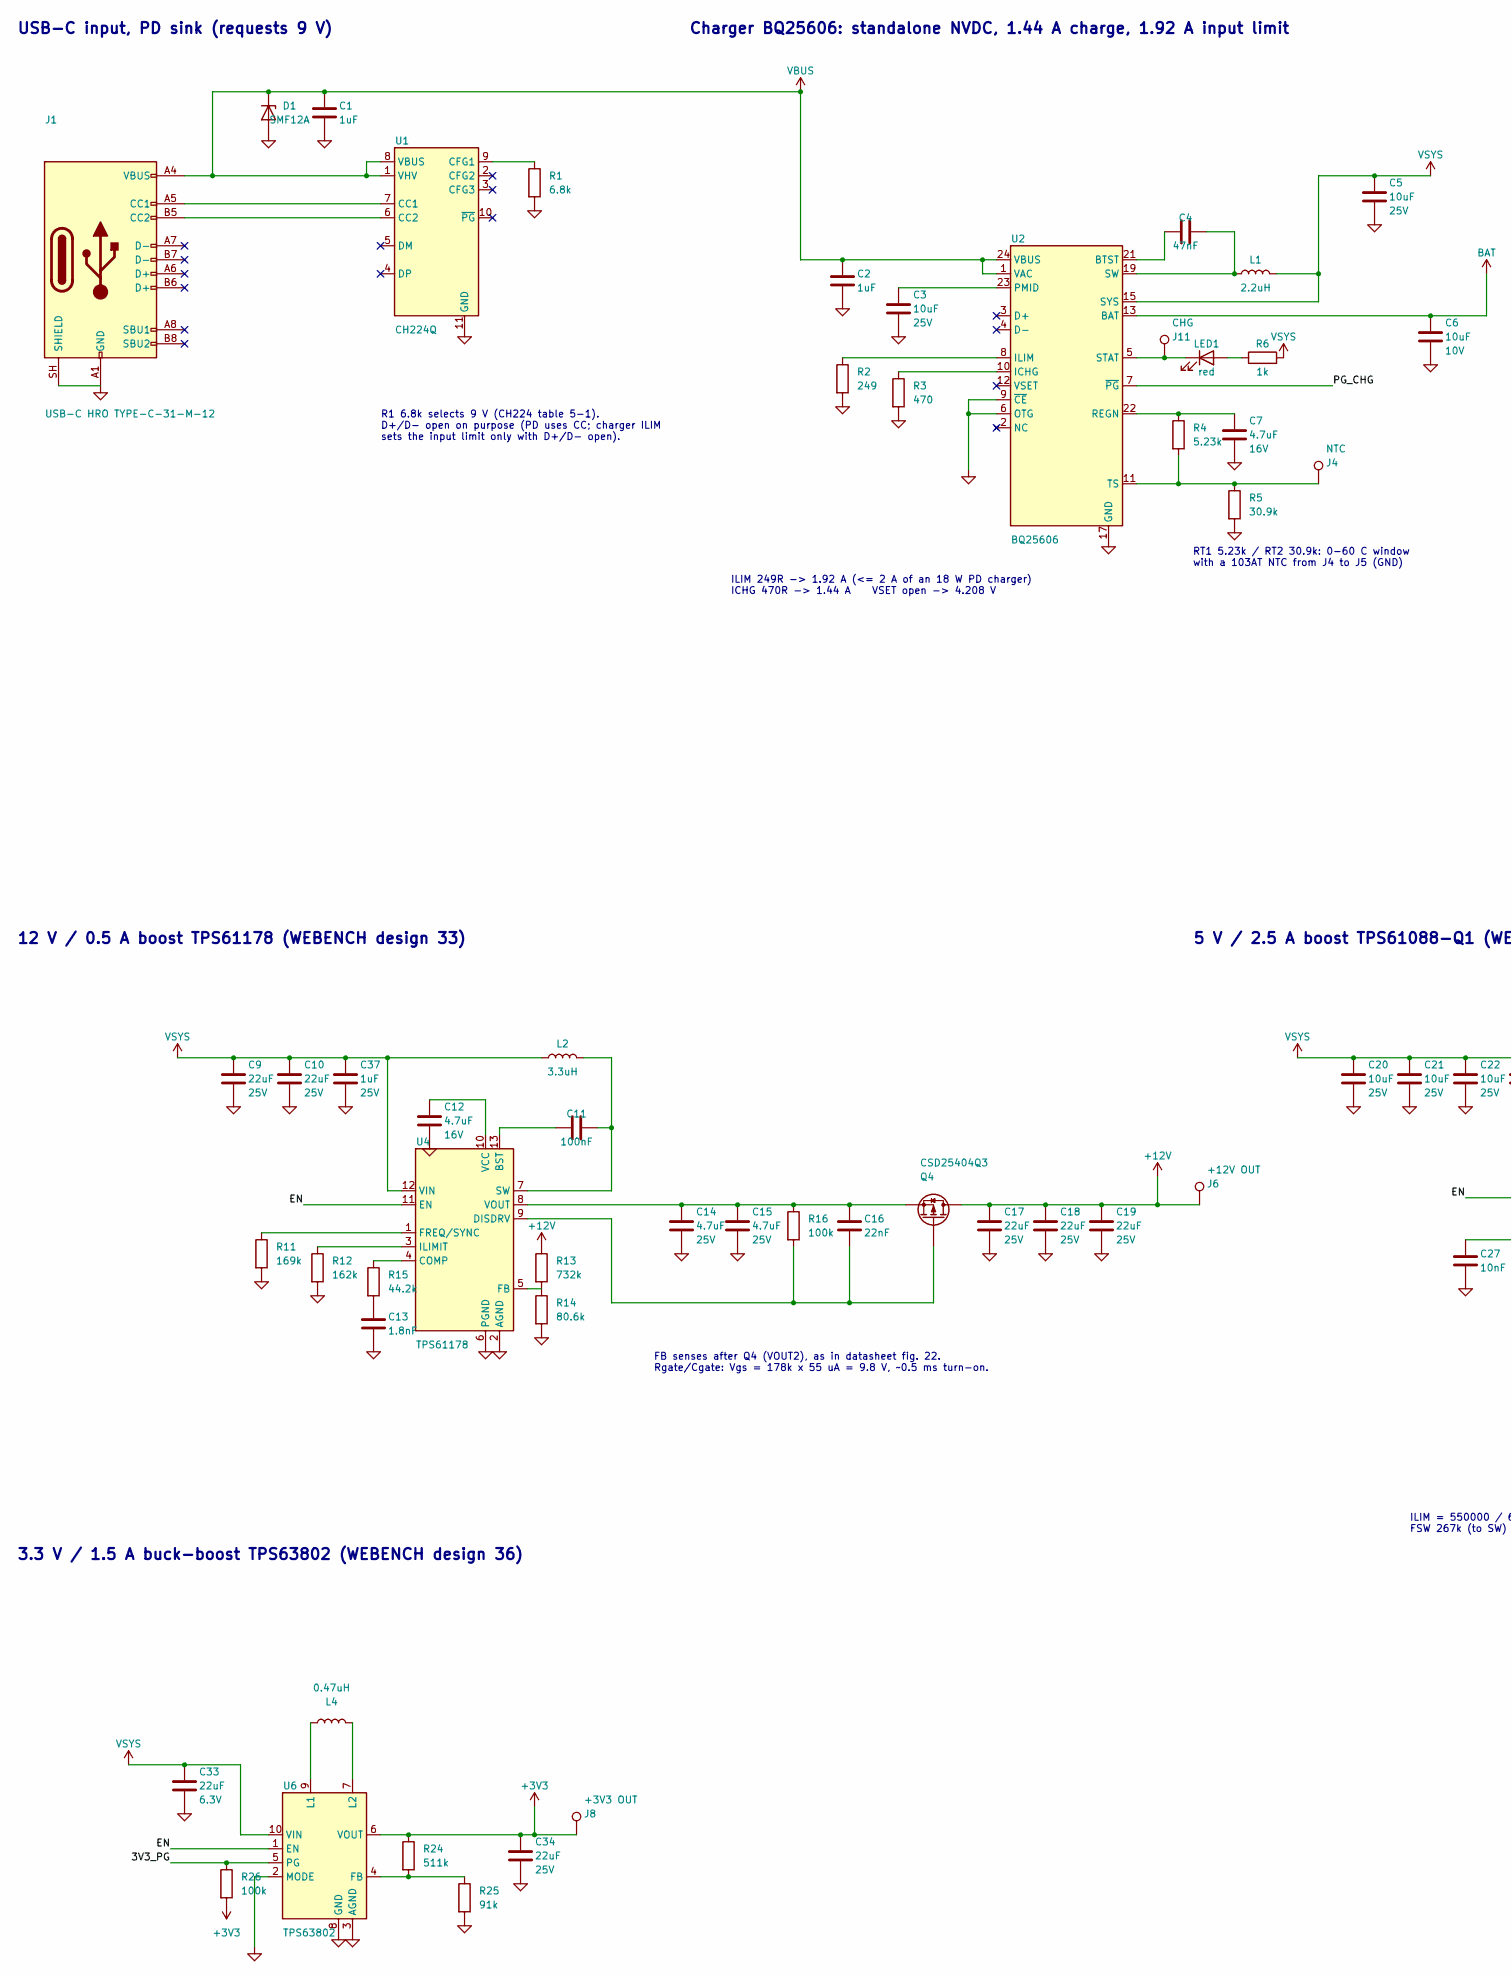
[picture p21: schematic minipc-power.kicad_sch, minipc-power: USB-C PD / 1S2P power board, part in row 1, column 1]

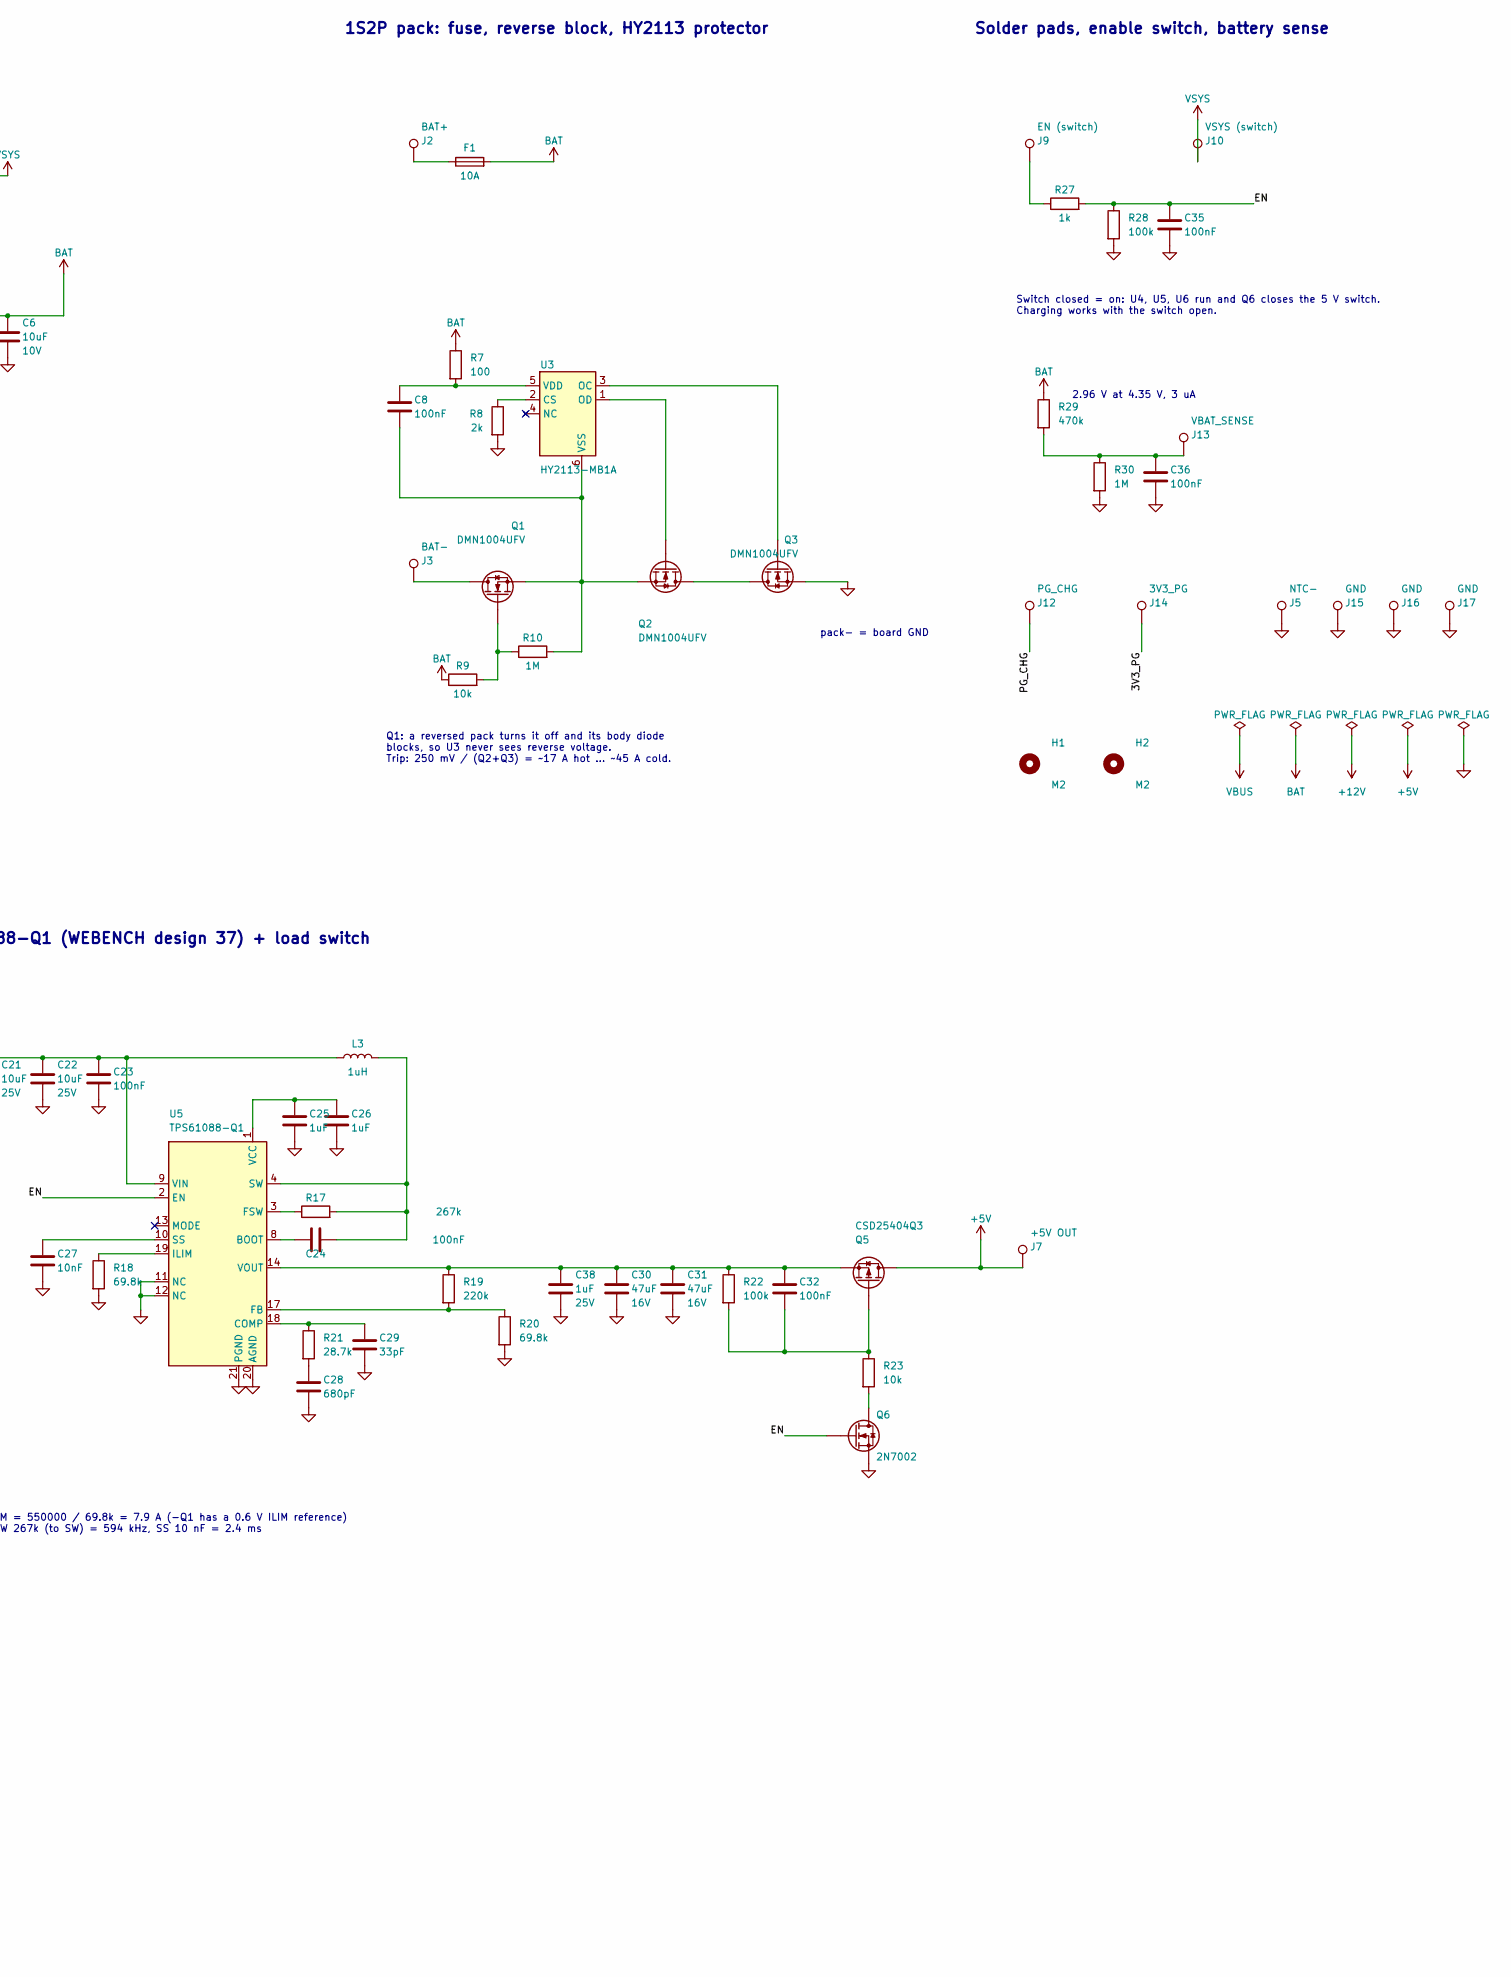
[picture p22: schematic minipc-power.kicad_sch, minipc-power: USB-C PD / 1S2P power board, part in row 1, column 2]

Parts:
C1, C2, C25, C26: 1uF; C_0603_1608Metric; LCSC C15849
C3, C5, C20, C21, C22: 10uF; C_0805_2012Metric; Voltage 25V; LCSC C15850
C4: 47nF; C_0402_1005Metric; LCSC C307434
C6: 10uF; C_0603_1608Metric; Voltage 10V; LCSC C19702
C7, C12: 4.7uF; C_0603_1608Metric; Voltage 16V; LCSC C19666
C8, C11, C23, C24, C32, C35, C36: 100nF; C_0402_1005Metric; LCSC C1525
C9, C10, C34: 22uF; C_0805_2012Metric; Voltage 25V; LCSC C45783
C13: 1.8nF; C_0402_1005Metric; LCSC C107024
C14, C15: 4.7uF; C_0805_2012Metric; Voltage 25V; LCSC C1779
C16: 22nF; C_0402_1005Metric; LCSC C337699
C17, C18, C19: 22uF; C_1210_3225Metric; Voltage 25V; LCSC C52306
C27: 10nF; C_0402_1005Metric; LCSC C15195
C28: 680pF; C_0402_1005Metric; LCSC C307451
C29: 33pF; C_0402_1005Metric; LCSC C70465
C30, C31: 47uF; C_1210_3225Metric; Voltage 16V; LCSC C77101
C33: 22uF; C_0603_1608Metric; Voltage 6.3V; LCSC C59461
C37, C38: 1uF; C_0402_1005Metric; Voltage 25V; LCSC C52923
D1: SMF12A; D_SOD-123F; LCSC C123800
F1: 10A; Fuse_Littelfuse-NANO2-451_453; LCSC C44479
H1, H2: M2; MountingHole_2.2mm_M2
J1: USB-C HRO TYPE-C-31-M-12; USB_C_Receptacle_HRO_TYPE-C-31-M-12; LCSC C165948
J2: BAT+; TestPoint_THTPad_2.5x2.5mm_Drill1.2mm
J3: BAT-; TestPoint_THTPad_D2.5mm_Drill1.2mm
J4: NTC; TestPoint_THTPad_2.0x2.0mm_Drill1.0mm
J5: NTC-; TestPoint_THTPad_D2.0mm_Drill1.0mm
J6: +12V OUT; TestPoint_THTPad_2.5x2.5mm_Drill1.2mm
J7: +5V OUT; TestPoint_THTPad_2.5x2.5mm_Drill1.2mm
J8: +3V3 OUT; TestPoint_THTPad_2.5x2.5mm_Drill1.2mm
J9: EN (switch); TestPoint_THTPad_2.0x2.0mm_Drill1.0mm
J10: VSYS (switch); TestPoint_THTPad_2.0x2.0mm_Drill1.0mm
J11: CHG; TestPoint_THTPad_2.0x2.0mm_Drill1.0mm
J12: PG_CHG; TestPoint_THTPad_2.0x2.0mm_Drill1.0mm
J13: VBAT_SENSE; TestPoint_THTPad_2.0x2.0mm_Drill1.0mm
J14: 3V3_PG; TestPoint_THTPad_2.0x2.0mm_Drill1.0mm
J15, J16, J17: GND; TestPoint_THTPad_D2.5mm_Drill1.2mm
L1: 2.2uH; FXL0630-2R2-M; LCSC C167218
L2: 3.3uH; FXL0630-3R3-M; LCSC C167219
L3: 1uH; FXL0630-1R0-M; LCSC C167216
L4: 0.47uH; FXL0530-R47-M; LCSC C475515
LED1: red; LED_0603_1608Metric; LCSC C2286
Q1, Q2, Q3: DMN1004UFV; Diodes_PowerDI3333-8; LCSC C316138
Q4, Q5: CSD25404Q3; VSON-8_3.3x3.3mm_P0.65mm_NexFET; LCSC C2865523
Q6: 2N7002; SOT-23; LCSC C8545
R1: 6.8k; R_0402_1005Metric; LCSC C25917
R2: 249; R_0402_1005Metric; LCSC C25096
R3: 470; R_0402_1005Metric; LCSC C25117
R4: 5.23k; R_0402_1005Metric; LCSC C25907
R5: 30.9k; R_0402_1005Metric; LCSC C270615
R6, R27: 1k; R_0402_1005Metric; LCSC C11702
R7: 100; R_0402_1005Metric; LCSC C25076
R8: 2k; R_0402_1005Metric; LCSC C4109
R9, R23: 10k; R_0402_1005Metric; LCSC C25744
R10, R30: 1M; R_0402_1005Metric; LCSC C26083
R11: 169k; R_0402_1005Metric; LCSC C25758
R12: 162k; R_0402_1005Metric; LCSC C54068
R13: 732k; R_0402_1005Metric; LCSC C27016
R14: 80.6k; R_0402_1005Metric; LCSC C25921
R15: 44.2k; R_0402_1005Metric; LCSC C25895
R16, R22, R26, R28: 100k; R_0402_1005Metric; LCSC C25741
R17: 267k; R_0402_1005Metric; LCSC C270622
R18, R20: 69.8k; R_0402_1005Metric; LCSC C26985
R19: 220k; R_0402_1005Metric; LCSC C25767
R21: 28.7k; R_0402_1005Metric; LCSC C26972
R24: 511k; R_0402_1005Metric; LCSC C64042
R25: 91k; R_0402_1005Metric; LCSC C144733
R29: 470k; R_0402_1005Metric; LCSC C25790
U1: CH224Q; CH224Q_C46061833; LCSC C46061833
U2: BQ25606; Texas_RGE0024H_VQFN-24-1EP_4x4mm_P0.5mm_EP2.7x2.7mm_Thermal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; LCSC C374063
U3: HY2113-MB1A; SOT-23-6; LCSC C168772
U4: TPS61178; TPS61178RNWR; LCSC C127918
U5: TPS61088-Q1; Texas_VQFN-RHL-20_ThermalVias; LCSC C1850341
U6: TPS63802; TPS63802DLAR; LCSC C2845237

Connections:
+3V3: C34.1, J8.1, R24.1, R26.2, U6.6 (VOUT)
+5V: J7.1, Q5.1 (D), Q5.2 (D), Q5.3 (D)
+12V: C17.1, C18.1, C19.1, J6.1, Q4.1 (D), Q4.2 (D), Q4.3 (D), R13.1
/3V3_PG: J14.1, R26.1, U6.5 (PG)
/EN: C35.1, Q6.1 (G), R27.2, R28.1, U4.11 (EN), U5.2 (EN), U6.1 (EN)
/PG_CHG: J12.1, U2.7 (~PG)
BAT: C6.1, F1.2, R7.1, R9.1, R29.1, U2.13 (BAT), U2.14 (BAT)
GND: C1.2, C2.2, C3.2, C5.2, C6.2, C7.2, C9.2, C10.2, C12.2, C13.2, C14.2, C15.2, C17.2, C18.2, C19.2, C20.2, C21.2, C22.2, C23.2, C25.2, C26.2, C27.2, C28.2, C29.2, C30.2, C31.2, C33.2, C34.2, C35.2, C36.2, C37.2, C38.2, D1.2 (A), J1.A1 (GND), J1.A12 (GND), J1.B1 (GND), J1.B12 (GND), J1.SH (SHIELD), J5.1, J15.1, J16.1, J17.1, Q3.1 (S), Q3.2 (S), Q3.3 (S), Q6.2 (S), R1.2, R2.2, R3.2, R5.2, R8.2, R11.2, R12.2, R14.2, R18.2, R20.2, R25.2, R28.2, R30.2, U1.11 (GND), U2.6 (OTG), U2.9 (~CE), U2.17 (GND), U2.18 (GND), U2.25 (GND), U4.2 (AGND), U4.6 (PGND), U5.11 (NC), U5.12 (NC), U5.20 (AGND), U5.21 (PGND), U6.2 (MODE), U6.3 (AGND), U6.8 (GND)
unnamed: C4.2, L1.1, U2.19 (SW), U2.20 (SW)
unnamed: C13.1, R15.2
unnamed: C24.2, L3.2, R17.2, U5.4 (SW), U5.5 (SW), U5.6 (SW), U5.7 (SW)
unnamed: C28.1, R21.2
unnamed: C36.1, J13.1, R29.2, R30.1
unnamed: F1.1, J2.1
unnamed: J1.A5 (CC1), U1.7 (CC1)
unnamed: J1.B5 (CC2), U1.6 (CC2)
unnamed: J9.1, R27.1
unnamed: LED1.2 (A), R6.1
unnamed: J11.1, LED1.1 (K), U2.5 (STAT)
unnamed: J3.1, Q1.5 (D)
unnamed: Q1.4 (G), R9.2, R10.1
unnamed: Q2.5 (D), Q3.5 (D)
unnamed: Q2.4 (G), U3.1 (OD)
unnamed: Q3.4 (G), U3.3 (OC)
unnamed: C16.2, Q4.4 (G), R16.2, U4.9 (DISDRV)
unnamed: C14.1, C15.1, C16.1, Q4.5 (S), R16.1, U4.8 (VOUT)
unnamed: C32.2, Q5.4 (G), R22.2, R23.1
unnamed: C30.1, C31.1, C32.1, C38.1, Q5.5 (S), R19.1, R22.1, U5.14 (VOUT), U5.15 (VOUT), U5.16 (VOUT)
unnamed: Q6.3 (D), R23.2
unnamed: R1.1, U1.9 (CFG1)
unnamed: C4.1, U2.21 (BTST)
unnamed: R3.1, U2.10 (ICHG)
unnamed: R2.1, U2.8 (ILIM)
unnamed: C3.1, U2.23 (PMID)
unnamed: C7.1, R4.1, U2.22 (REGN)
unnamed: J4.1, R4.2, R5.1, U2.11 (TS)
unnamed: R8.1, U3.2 (CS)
unnamed: C8.1, R7.2, U3.5 (VDD)
unnamed: C8.2, Q1.1 (S), Q1.2 (S), Q1.3 (S), Q2.1 (S), Q2.2 (S), Q2.3 (S), R10.2, U3.6 (VSS)
unnamed: C11.1, U4.13 (BST)
unnamed: R15.1, U4.4 (COMP)
unnamed: R13.2, R14.1, U4.5 (FB)
unnamed: R11.1, U4.1 (FREQ/SYNC)
unnamed: R12.1, U4.3 (ILIMIT)
unnamed: C11.2, L2.2, U4.7 (SW)
unnamed: C12.1, U4.10 (VCC)
unnamed: C24.1, U5.8 (BOOT)
unnamed: C29.1, R21.1, U5.18 (COMP)
unnamed: R19.2, R20.1, U5.17 (FB)
unnamed: R17.1, U5.3 (FSW)
unnamed: R18.1, U5.19 (ILIM)
unnamed: C27.1, U5.10 (SS)
unnamed: C25.1, C26.1, U5.1 (VCC)
unnamed: R24.2, R25.1, U6.4 (FB)
unnamed: L4.1, U6.9 (L1)
unnamed: L4.2, U6.7 (L2)
VBUS: C1.1, C2.1, D1.1 (K), J1.A4 (VBUS), J1.A9 (VBUS), J1.B4 (VBUS), J1.B9 (VBUS), U1.1 (VHV), U1.8 (VBUS), U2.1 (VAC), U2.24 (VBUS)
VSYS: C5.1, C9.1, C10.1, C20.1, C21.1, C22.1, C23.1, C33.1, C37.1, J10.1, L1.2, L2.1, L3.1, R6.2, U2.15 (SYS), U2.16 (SYS), U4.12 (VIN), U5.9 (VIN), U6.10 (VIN)

Notes on the sheet:
USB-C input, PD sink (requests 9 V)
R1 6.8k selects 9 V (CH224 table 5-1). D+/D- open on purpose (PD uses CC; charger ILIM sets the input limit only with D+/D- open).
Charger BQ25606: standalone NVDC, 1.44 A charge, 1.92 A input limit
ILIM 249R -> 1.92 A (<= 2 A of an 18 W PD charger) ICHG 470R -> 1.44 A VSET open -> 4.208 V
RT1 5.23k / RT2 30.9k: 0-60 C window with a 103AT NTC from J4 to J5 (GND)
1S2P pack: fuse, reverse block, HY2113 protector
pack- = board GND
Q1: a reversed pack turns it off and its body diode blocks, so U3 never sees reverse voltage. Trip: 250 mV / (Q2+Q3) = ~17 A hot ... ~45 A cold.
Solder pads, enable switch, battery sense
Switch closed = on: U4, U5, U6 run and Q6 closes the 5 V switch. Charging works with the switch open.
2.96 V at 4.35 V, 3 uA
12 V / 0.5 A boost TPS61178 (WEBENCH design 33)
FB senses after Q4 (VOUT2), as in datasheet fig. 22. Rgate/Cgate: Vgs = 178k x 55 uA = 9.8 V, ~0.5 ms turn-on.
5 V / 2.5 A boost TPS61088-Q1 (WEBENCH design 37) + load switch
ILIM = 550000 / 69.8k = 7.9 A (-Q1 has a 0.6 V ILIM reference) FSW 267k (to SW) = 594 kHz, SS 10 nF = 2.4 ms
3.3 V / 1.5 A buck-boost TPS63802 (WEBENCH design 36)

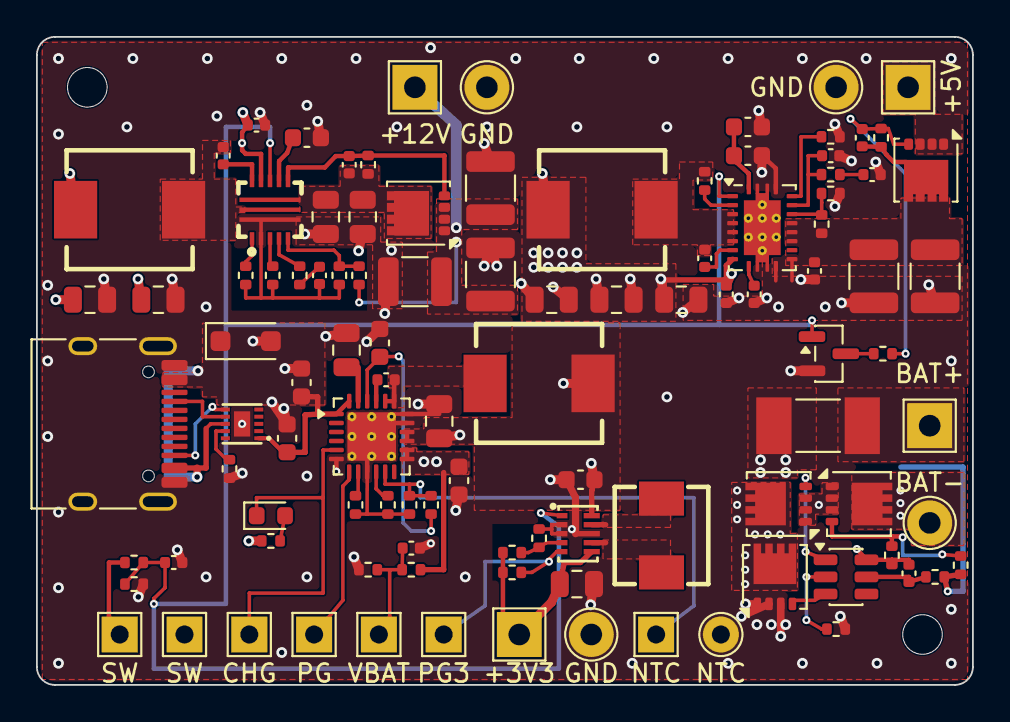
[picture p23: board minipc-power.kicad_pcb from above]

Board: 4 copper layers, 52.0 x 36.0 mm, 106 parts (0 on the bottom side), 58 nets.
