jvanderberg/minipc-power/docs/layout-refs/tps61088q1-5v/webench-d37.kicad_pcb

## KiCad design docs/layout-refs/tps61088q1-5v/webench-d37.kicad_pcb (2026-10-24)

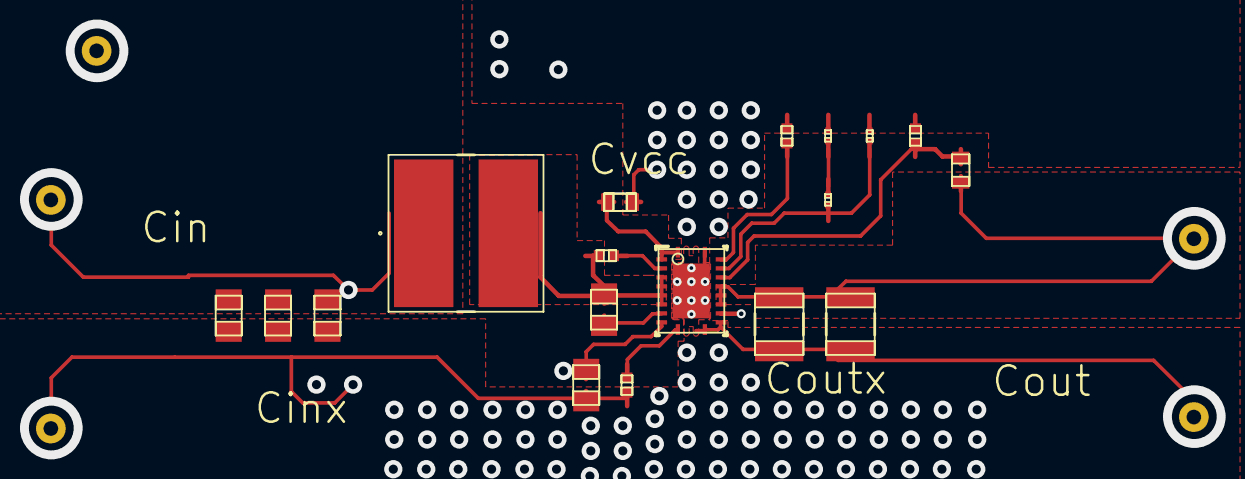
[picture p24: board webench-d37.kicad_pcb from above]

Board: 10 copper layers, 24 parts (0 on the bottom side), 13 nets.

Parts:
Cbst0: 0805
Ccomp0, Ccomp2: 0201
Cin2: 0805
Cin_1, Cin_2, Cin_3: 0805
Cout_1, Cout_2: 1210_280
Css0: 0402
Cvcc_1, Cvcc_2: 0603
GND0, GND1: TP-1502
L1: VLP8040
MODE0: TP-1502
Rcomp0: 0201
Rfbb0: 0402
Rfbt0: 0603
Rlim0: 0402
Rt0: 0402
U1: RHL0020A
VIN0: TP-1502
VOUT0: TP-1502

Connections:
0: Ccomp0.2, Ccomp2.2, Cin2.2, Cin_1.2, Cin_2.2, Cin_3.2, Cout_1.2, Cout_2.2, Css0.2, Cvcc_1.2, Cvcc_2.2, GND0.1, GND1.1, Rfbb0.2, Rlim0.2, U1.11, U1.12, U1.20, U1.21
2: Cin2.1, Cin_1.1, Cin_2.1, Cin_3.1, L1.1, U1.9, VIN0.1
3: Ccomp0.1, Rcomp0.2
4: Cvcc_1.1, Cvcc_2.1, U1.1, U1.2
5: Ccomp2.1, Rcomp0.1, U1.18
9: Cout_1.1, Cout_2.1, Rfbt0.1, U1.14, U1.15, U1.16, VOUT0.1
11: Rfbb0.1, Rfbt0.2, U1.17
12: Cbst0.1, L1.2, Rt0.1, U1.4, U1.5, U1.6, U1.7
14: Rlim0.1, U1.19
15: Rt0.2, U1.3
17: MODE0.1, U1.13
19: Css0.1, U1.10
21: Cbst0.2, U1.8
