jvanderberg/minipc-power/docs/layout-refs/tps61178-12v/webench-d33-view.kicad_pcb

## KiCad design docs/layout-refs/tps61178-12v/webench-d33-view.kicad_pcb (2026-10-24)

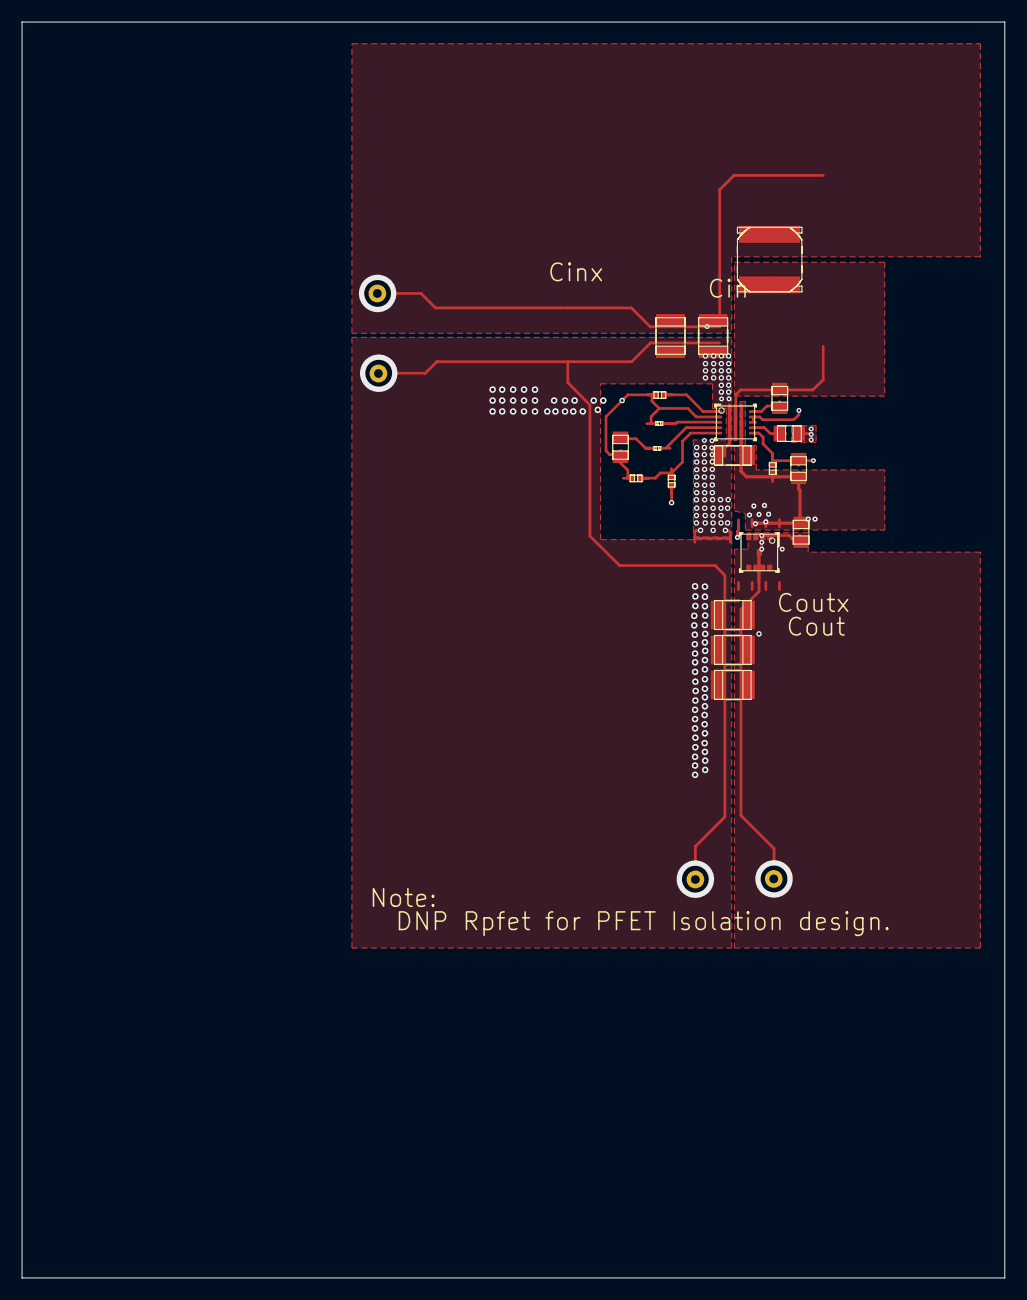
[picture p25: board webench-d33-view.kicad_pcb from above]

Board: 10 copper layers, 91.4 x 116.8 mm, 24 parts (0 on the bottom side), 13 nets.

Parts:
Cboot0: 0805
Ccomp0: 0805
Cgate0: 0805
Cin_1, Cin_2: 1210
Cout1: 1206
Cout_1, Cout_2, Cout_3: 1210
Cvcc0: 0805
GND0, GND1: TP-1502
L1: DG6045C
M3: DQG0008A
Rcomp0: 0201
Rfbb0: 0402
Rfbt0: 0402
Rgate0: 0402
Rilim0: 0201
Rpfet0: 0805
Rt0: 0402
U1: RNW0013A
VIN0: TP-1502
VOUT0: TP-1502

Connections:
0: Cboot0.2, U1.13
1: Cgate0.2, Rgate0.2, U1.9
2: Cgate0.1, Cout1.1, Rgate0.1, Rpfet0.1, U1.8
5: Rt0.1, U1.1
8: Cin_1.1, Cin_2.1, L1.2, U1.11, U1.12, VIN0.1
10: Cboot0.1, L1.1, U1.7
11: Rfbb0.1, Rfbt0.2, U1.5
13: Cout_1.1, Cout_2.1, Cout_3.1, M3.1, M3.2, M3.3, M3.4, M3.5, M3.6, M3.7, M3.8, M3.9, Rfbt0.1, Rpfet0.2, VOUT0.1
14: Ccomp0.1, Rcomp0.2
18: Ccomp0.2, Cin_1.2, Cin_2.2, Cout1.2, Cout_1.2, Cout_2.2, Cout_3.2, Cvcc0.2, GND0.1, GND1.1, Rfbb0.2, Rilim0.2, Rt0.2, U1.2, U1.6
19: Cvcc0.1, U1.10
24: Rcomp0.1, U1.4
27: Rilim0.1, U1.3
