jvanderberg/minipc-power/docs/layout-refs/tps63802-3v3/webench-d36.kicad_pcb

## KiCad design docs/layout-refs/tps63802-3v3/webench-d36.kicad_pcb (2026-10-24)

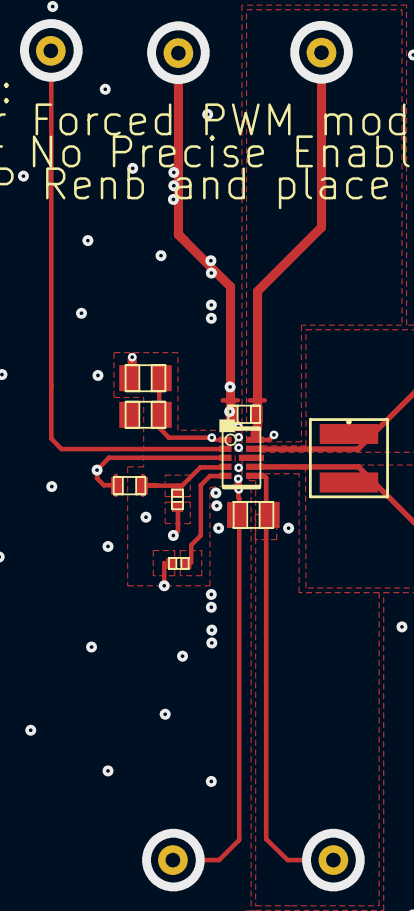
[picture p26: board webench-d36.kicad_pcb from above]

Board: 10 copper layers, 14 parts (0 on the bottom side), 8 nets.

Parts:
Cin0: 0603
Cout0: 0805
GND0, GND1: TP-1502
L1: XFL4015
MODE0: TP-1502
Renb0: 0805
Rent0: 0805
Rfbb0: 0603
Rfbt0: 0402
Rpg0: 0402
U1: DLA0010A
VIN0: TP-1502
VOUT0: TP-1502

Connections:
0: Cin0.2, Cout0.2, GND0.1, GND1.1, Renb0.2, Rfbb0.2, U1.3, U1.8
2: Cin0.1, Renb0.1, Rent0.1, Rent0.2, U1.1, U1.10, VIN0.1
5: Rfbb0.1, Rfbt0.2, U1.4
7: Cout0.1, Rfbt0.1, Rpg0.1, U1.6, VOUT0.1
9: L1.2, U1.7
10: Rpg0.2, U1.5
11: MODE0.1, U1.2
13: L1.1, U1.9
