jvanderberg/minipc-power/docs/layout-refs/webench-raw/d37/ExportFiles/Board/webench_board_exchange_design_18395157_37_Eagle/Eagle/2026-10-24_14-24-42/2026-10-24_14-24-42.brd

## EAGLE design docs/layout-refs/webench-raw/d37/ExportFiles/Board/webench_board_exchange_design_18395157_37_Eagle/Eagle/2026-10-24_14-24-42/2026-10-24_14-24-42.brd (2026-10-24)

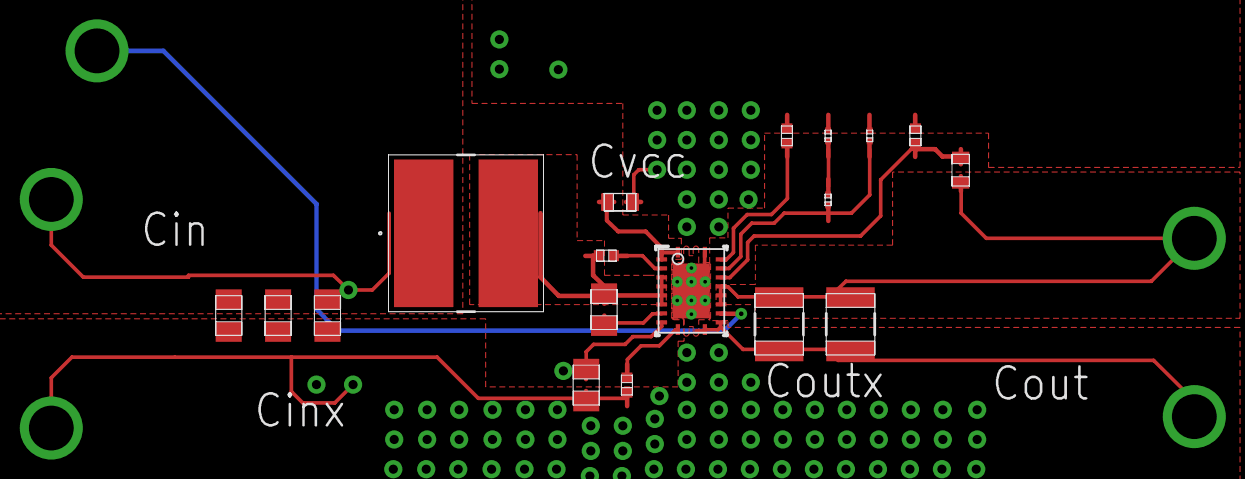
[picture p27: board 2026-10-24_14-24-42.brd from above]

Board: 4 copper layers, 24 parts (0 on the bottom side), 13 nets.

Parts:
Cbst: 0805
Ccomp, Ccomp2: 0201
Cin2: 0805
Cin_1, Cin_2, Cin_3: 0805
Cout_1, Cout_2: 1210_280
Css: 0402
Cvcc_1, Cvcc_2: 0603
GND, GND1: TP-1502
L1: VLP8040
MODE: TP-1502
Rcomp: 0201
Rfbb: 0402
Rfbt: 0603
Rlim: 0402
Rt: 0402
U1: RHL0020A
VIN: TP-1502
VOUT: TP-1502

Connections:
0: Ccomp.2, Ccomp2.2, Cin2.2, Cin_1.2, Cin_2.2, Cin_3.2, Cout_1.2, Cout_2.2, Css.2, Cvcc_1.2, Cvcc_2.2, GND.1, GND1.1, Rfbb.2, Rlim.2, U1.11, U1.12, U1.20, U1.21
2: Cin2.1, Cin_1.1, Cin_2.1, Cin_3.1, L1.1, U1.9, VIN.1
3: Ccomp.1, Rcomp.2
4: Cvcc_1.1, Cvcc_2.1, U1.1, U1.2
5: Ccomp2.1, Rcomp.1, U1.18
9: Cout_1.1, Cout_2.1, Rfbt.1, U1.14, U1.15, U1.16, VOUT.1
11: Rfbb.1, Rfbt.2, U1.17
12: Cbst.1, L1.2, Rt.1, U1.4, U1.5, U1.6, U1.7
14: Rlim.1, U1.19
15: Rt.2, U1.3
17: MODE.1, U1.13
19: Css.1, U1.10
21: Cbst.2, U1.8
