jvanderberg/minipc-power/docs/layout-refs/webench-raw/d33/ExportFiles/Board/webench_board_exchange_design_18395157_33_Eagle/Eagle/2026-10-24_14-10-16/2026-10-24_14-10-16.brd

## EAGLE design docs/layout-refs/webench-raw/d33/ExportFiles/Board/webench_board_exchange_design_18395157_33_Eagle/Eagle/2026-10-24_14-10-16/2026-10-24_14-10-16.brd (2026-10-24)

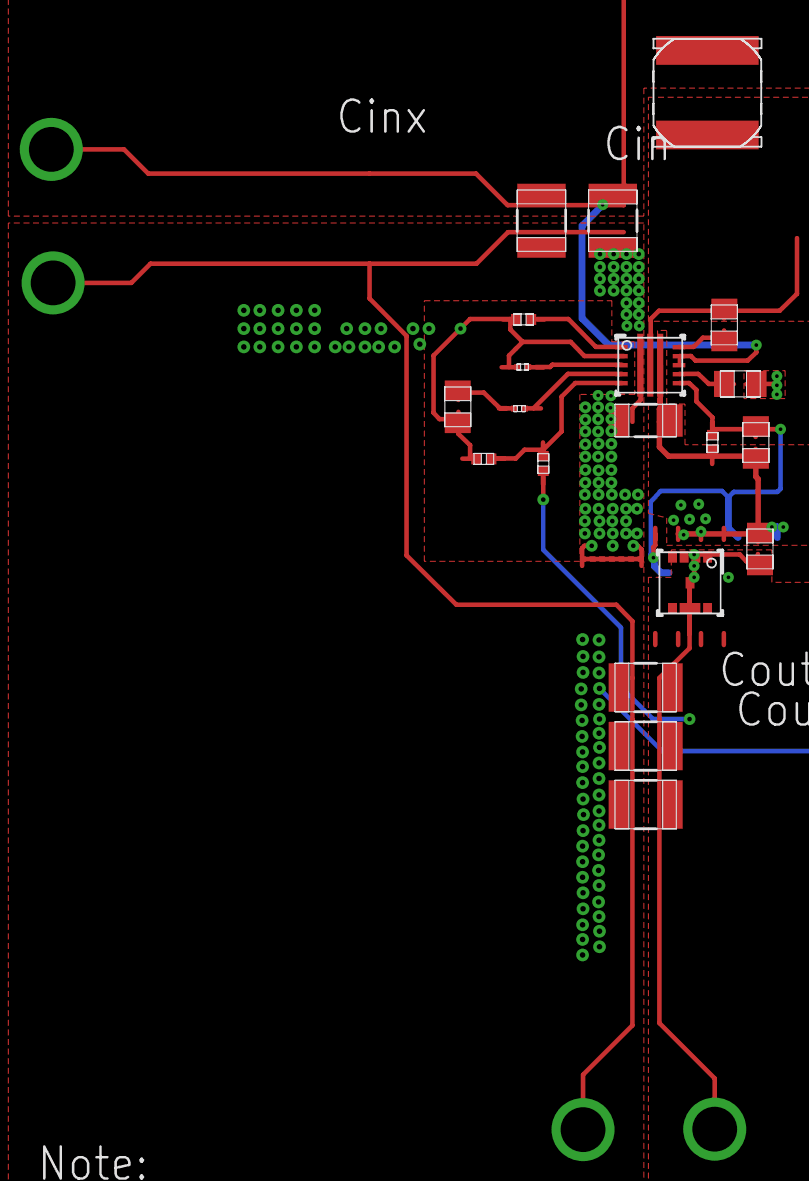
[picture p28: board 2026-10-24_14-10-16.brd from above]

Board: 4 copper layers, 24 parts (0 on the bottom side), 13 nets.

Parts:
Cboot: 0805
Ccomp: 0805
Cgate: 0805
Cin_1, Cin_2: 1210
Cout1: 1206
Cout_1, Cout_2, Cout_3: 1210
Cvcc: 0805
GND, GND1: TP-1502
L1: DG6045C
M3: DQG0008A
Rcomp: 0201
Rfbb: 0402
Rfbt: 0402
Rgate: 0402
Rilim: 0201
Rpfet: 0805
Rt: 0402
U1: RNW0013A
VIN: TP-1502
VOUT: TP-1502

Connections:
0: Cboot.2, U1.13
1: Cgate.2, Rgate.2, U1.9
2: Cgate.1, Cout1.1, Rgate.1, Rpfet.1, U1.8
5: Rt.1, U1.1
8: Cin_1.1, Cin_2.1, L1.2, U1.11, U1.12, VIN.1
10: Cboot.1, L1.1, U1.7
11: Rfbb.1, Rfbt.2, U1.5
13: Cout_1.1, Cout_2.1, Cout_3.1, M3.1, M3.2, M3.3, M3.4, M3.5, M3.6, M3.7, M3.8, M3.9, Rfbt.1, Rpfet.2, VOUT.1
14: Ccomp.1, Rcomp.2
18: Ccomp.2, Cin_1.2, Cin_2.2, Cout1.2, Cout_1.2, Cout_2.2, Cout_3.2, Cvcc.2, GND.1, GND1.1, Rfbb.2, Rilim.2, Rt.2, U1.2, U1.6
19: Cvcc.1, U1.10
24: Rcomp.1, U1.4
27: Rilim.1, U1.3
