jvanderberg/minipc-power/docs/layout-refs/webench-raw/d36/ExportFiles/Schematic/webench_schematic_exchange_design_18395157_36_Eagle/Eagle/2026-10-24_14-12-31/2026-10-24_14-12-31.sch

## EAGLE design docs/layout-refs/webench-raw/d36/ExportFiles/Schematic/webench_schematic_exchange_design_18395157_36_Eagle/Eagle/2026-10-24_14-12-31/2026-10-24_14-12-31.sch (2026-10-24)

Schematic: 2026-10-24_14-12-31.sch

Parts:
GND: WB_GND
L1: 470nH; XFL4015
U1: TPS63802DLAR; DLA0010A
