jvanderberg/minipc-power/(commit log)

2026-10-24 Requirements draft and kicad-skills gap log
2026-10-24 Requirements rev 2: 3V3 rail, amp on 5V, reverse-battery FET, mounting holes
2026-10-24 WEBENCH results for 12 V, 5 V and 3.3 V rails; more skill gaps
2026-10-24 5 V rail: TPS61088-Q1 (commercial TPS61088 appears discontinued); Q1 WEBENCH design and layout reference
2026-10-24 Power design, layout reference pack, protector corrected to 1-cell HY2113
2026-10-24 Schematic generator: redrawn symbols, wired blocks, netlist checked against netspec; ERC clean
2026-10-24 Field placement rules, right-aligned top/bottom pins; ignore KiCad local history
2026-10-24 Schematic refinement pass: spacing, field placement, symbol rows, 3V3 block moved; skill-gap notes on an s-expression layer
2026-10-24 Board stage 1: 4-layer JLC04161H-7628 board from the schematic netlist (parity clean), rules, net classes, courtyards on imported footprints
2026-10-24 Board placement v1: three bands, converters per datasheet layout examples, 0 courtyard overlaps
2026-10-24 Pad labels on both silkscreens, round GND/negative pads, refs moved to fab layer, 3D models for F1 and J1
2026-10-24 Drop CH224Q D+/D- (PD uses CC), re-orient U1, charger-area placement for routability; routing infrastructure
2026-10-24 Route USB/PD, charger and protection; FETs alternate orientation; router keeps via holes apart
2026-10-24 Log gap 20: no router helper / same-net hole-to-hole (kicad-skills#1)
2026-10-24 Charger to datasheet fig. 12-2: C_SYS at SYS/GND pins, single-point analog ground with pour keepout; compliance log; gap 21
2026-10-24 Gap 22: one agent session per layout stage with a brief; 12V re-placement per fig. 36
2026-10-24 Route 12V boost per TPS61178 fig. 36 (COUT1 at bar ends, AGND bus, gate along top)
2026-10-24 Route 5V boost per TPS61088-Q1 fig. 21; load switch top-right (+5V/GND top pads swapped)
2026-10-24 Route 3.3V buck-boost per TPS63802 fig. 12-1 / WEBENCH d36; TS rerouted off U6
2026-10-24 Route EN bus, switch pad, VBAT sense; board fully routed (DRC 0, unconnected 0)
2026-10-24 Pad labels beside the 5 V pads / above BAT-; tool notes (keepout, silk under bodies)
2026-10-24 Add C37 1uF 0402 VIN-pin bypass for the 12V boost (TPS61178 layout rule 5); board regeneration pending (KiCad open)
2026-10-24 Regenerate board with C37 and pad-label fixes; DRC summary no longer hides silk warnings
2026-10-24 Project files as KiCad 10 saved them (key order, net-class assignments as lists, sheet list, panel state)
2026-10-24 Tools on kicad_sexpr (no hand-formatted KiCad text); U5 3D model; recorded pin decisions checked in the build
    - schgen / symbols / gen_board / routing / apply_routes / board_setup write through kicad-skills' kicad_sexpr layer
    (pinned via tools/kskills.py, KICAD_SEXPR overrides); gen_board no longer needs pcbnew
    - U5: KiCad's VQFN-RHL-20 model is not installed; point it at LCSC C1850341's model (rotation checked by the pin-1 dot)
    - docs/pin-decisions.json: datasheet-backed decision for every unused or strapped pin; build fails if one is missing
    - build_board.sh refuses only when KiCad has THIS project open (lock file or open files here), not on any KiCad process
    - untrack __pycache__
2026-10-24 Stable ids and clean rebuilds: an unchanged design regenerates byte-identical
    - schgen / gen_board / apply_routes / board_setup reuse the ids of the files they replace (kicad_sexpr previous= /
    reuse_ids; build_board.sh snapshots the board first). Rebuild vs committed: schematic 0 lines, board 0 lines apart
    from zone fills, 2383 of 2383 board ids kept
    - zone fills are derived and KiCad's refill is not deterministic: build keeps the previous board when only fills
    changed (tools/fills.py same), and git diffs hide fills (.gitattributes + textconv, set by build_board.sh)
    - kskills.py appends kicad-skills' scripts folder instead of prepending it: its generic module names (schgen,
    netspec,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
2026-10-25 Design review 2026-10-24 (kicad-skills board review): fixes, datasheet links on every part
    Fixes found by the review (docs/review-2026-10-24.md):
    - R25 91k: LCSC C4147 (2 in stock) -> C144733
    - U5 TPS61088-Q1: C38 1 uF 0402 at the VOUT pins (datasheet fig. 13 C9, fig. 21); NC pins 11/12 tied to GND
    as the pin table asks (symbol pins passive)
    - Q5 load switch: C32 10 nF -> 100 nF (~1 ms turn-on; inrush could trip the BQ25606 BATFET OCP latch)
    - U6 TPS63802: C33 ground on a top-layer track to PGND pin 8 (fig. 12-1); C_OUT side still open
    - R7 330 -> 100 R (HY2113 100-200 R); R16 178k -> 100k (Q4 Vgs margin to +/-12 V)
    - power-design.md / layout-compliance.md corrected against the board (R_IC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
2026-10-25 Heat: thermal budget, GND stitching vias, B.Cu copper under the protection FETs
    docs/thermal.md: heat sources per operating case (battery path dominates at high load: 5.0 W on the board at 15 W
    from an empty cell), board temperature in a closed box (15 W is a peak rating, ~10-12 W continuous), hot spots,
    options. route_plan: stitch_grid() edge ring + interior GND vias (edge vias 6 -> 34, worst edge gap 57 -> 17 mm),
    second vias at C18/C1, same-net B.Cu islands with 16 vias under Q1-Q3 (R7 BAT feed moved to the right edge).
    DRC 0 violations, 0 unconnected, parity 0. hardware/production/ predates these vias: regenerate before ordering.
2026-10-25 README: features (all three rails, charger, protection, budget), status, files
2026-10-25 Protection FETs: DMN1004UFV, block re-laid out with B.Cu copper; heat 5.0 -> 3.4 W at 15 W
    Q1-Q3 CSD13202Q2 (8.4 mOhm at 3 V) -> Diodes DMN1004UFV (C316138, 3.2 / 5.1 mOhm at 2.5 V, PowerDI3333-8;
    KiCad Diodes_PowerDI3333-8 checked against the datasheet's suggested pads; JLCImport 3D model, orientation checked
    by the pin-1 dot). FET loss at 15 W from an empty cell 1.72 -> 0.53 W, board 5.0 -> 3.4 W (docs/thermal.md).
    The 3.3 mm parts no longer fit in a row: Q2 | Q1 face across the CELLN gap, Q1's drain at J3, Q3 under Q2's drain;
    U3 between Q3 and H2's keep-out, R7-R10 / C8 under J3. Same-net B.Cu islands joined by vias; OD, CS and Q1's gate
    take short B.Cu lanes. U3 stays HY2113-MB1A: its F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
2026-10-25 Checks on kicad-skills e4b8240: sourcing.json, DRC exemption file, no vias on pads
    docs/sourcing.json (JLCPCB, global warehouse, 5 boards) for the stock scripts (R24); docs/drc-accept.json names the
    one accepted DRC item (J1's silk over the edge) for check.sh. routing.via_near keeps every via off every pad,
    including the pad it stitches (board_lint flagged rings on C17/C18/C19/C31); stitch_pads falls back to a 0.45/0.2
    via where a 0.6/0.3 with a mask web does not fit (C36). Schematic unchanged. DRC 0 (J1 silk accepted), ERC 0,
    unconnected 0, parity 0, board_lint 0 problems (note: U1's exposed-pad via, deliberate), pins and fields clean.
